ouyangcong3/LongShaoCPU/龙少设计CPU/KC-LS1u资料文件(更新1)/示例程序/TF_SD卡读写示例程序/程序说明.txt

读写内存卡(TF/SD).

内存卡连接定义:

/*------内存卡接 "KC_LS1u_SPI_C" 和 "KC_LS1u_SPI_D" PCB的J7接口

内存卡是接到J7接口. 
内存卡的 "VCC" 接 "3V" 
内存卡的 "GND" 接 "GND" 
内存卡的 "MISO" 接 "SI" 
内存卡的 "MOSI" 接 "SO" 
内存卡的 "SCK" 接 "SCK" 
内存卡的 "CS" 接 "S_CS0"

"S_CS0" ~ "S_CS7" ,分别为设备0到设备7
这里的8个SPI设备都共用SCK、SI、SO、VCC、GND这5条线,不同的是J7接口是3.3V,J8接口是5V

*/

程序功能: 把内存卡的0号扇区的数据复制到1号扇区.
