ouyangcong3/LongShaoCPU/龙少设计CPU/KC-LS1u资料文件(更新1)/示例程序/USB存储器(U盘)读写示例程序/程序说明.txt

读写USB存储器(U盘).

CH375连接定义:

/*----CH375 接 "KC_LS1u_CLK_RST_IO_PS" PCB上的J5、J6、J7、J8接口;

CH375的VCC和GND电源线接J7或J8接口上的VCC和GND;
CH375的D0~D7数据线接J7或J8接口上的D0~D7;
CH375的WR和RD读写线接J7或J8接口上的WR和RD;
CH375的A0线接J7或J8接口上的A0;
CH375的CS片选线J5或J6接口上的CS0;
CH375的INT中断信号线接J5或J6接口上的IT0;

CS0~CS7,为设备0~设备8;
IT0~IT7,为设备0~设备8;

这里程序支持4片CH375, 也就是CS0~CS3和IT0~IT3可以接4片CH375, 4片CH375的D0~D7、WR、RD、A0、VCC、GND共用, 如果不够可以扩展出来;

*/

程序功能: 每次插入USB存储器,就会把存储器0号扇区的数据复制到1号扇区.
