ouyangcong3/LongShaoCPU/龙少设计CPU/KC-LS1u资料文件(更新1)/示例程序/扬声器示例程序/程序说明.txt

测试扬声器.

扬声器连接定义:

/* 扬声器接 "KC_LS1u_CLK_RST_IO_PS" PCB 的"Speaker"接口*/
