ouyangcong3/LongShaoCPU/龙少设计CPU/龙少各帖子说明.pdf龙少各帖子说明.pdf

1.用Multisim 11.0画了个CPU来玩玩(纯硬件、开源、原创) 制作了最早 的龙少八位机，发布了多页的纸质说明
2.龙少精简炮灰测试版8位机(原创、纯硬件、开源) 使用洞洞版制作外 设卡，使用整块自制pcb制作了主体，发布了架构图，PCB制作过程，CPU 的使用说明，CPU的寄存器，CPU的寻址方式、指令、和机器码，自己的经 历，简单地讲解了一下运作过程，发布了汇编器，发布硬件SPI，有人给 他制作了C语言的编译器
3.正在测试小UU外设部分(不定时更新) 计划运行程序HTTP服务器，制作 了ROM下载器，测试了VGA-RGB的D--A部分，投入到显示卡的研发中，制作 了SPI收发板，介绍了造CPU, 写编译器, 网络协议, VGA显示的基础原理 的图书，发布了二元式CPU指令生成程序，更新了SPI收发电路，显卡分辨 率调整电路从240 X 240 改为256(宽) X 240(高) 4.YY了一个单周期自动机(独家原创含讲解) 发布了基本结构，执行代码 时各寄存器的导路，产生了二级流水线
5.龙少精简嗨爆版8位单周期CPU内核原创电路发布(计划出套件) 发布完 整指令集，完成如今的14片10×10cm主板
6.DIY的测试版8位计算机完整原创电路和部分程序发布 发布较为完整的 资料
7.KC-LS1u简介和预订 有关于转换视频的教程，发现设计有误、添加c寄 存器
8.74门电路8位计算机KC-LS1u部分资料发布 打包新文件，发布反汇编器 9.74门电路8位计算机KC-LS1u资料(更新1) 最后一次发布文件

龙少最后一次登录科创：2017-08-17 16:23

Emmm,对龙少的8位74门机子比较感兴趣，但由于他的帖子比较杂乱，为了方 便各位的阅读，在此小小地整合了一下他的所有帖子的内容索引，后面的越写越少 真的不是我的错23333，哦，对了那啥——严禁用作商业用途（真有的话我只能佩 服一句吃饱了撑的233）
——左手执者 2018-9-13
阿诺内，阿诺内（自行脑补血小板音效）我最近也在做74门计算机，有兴趣的欢迎
关顾一下寒舍吧 科创： Click Here (https://www.kechuang.org/m/76042) | B站： Click Here (https://space.bilibili.com/28690875/#/)
