ouyangcong3/LongShaoCPU/龙少设计CPU/KC-LS1u资料文件(更新1)/示例程序/USB键盘示例程序/DSCF5973.JPG

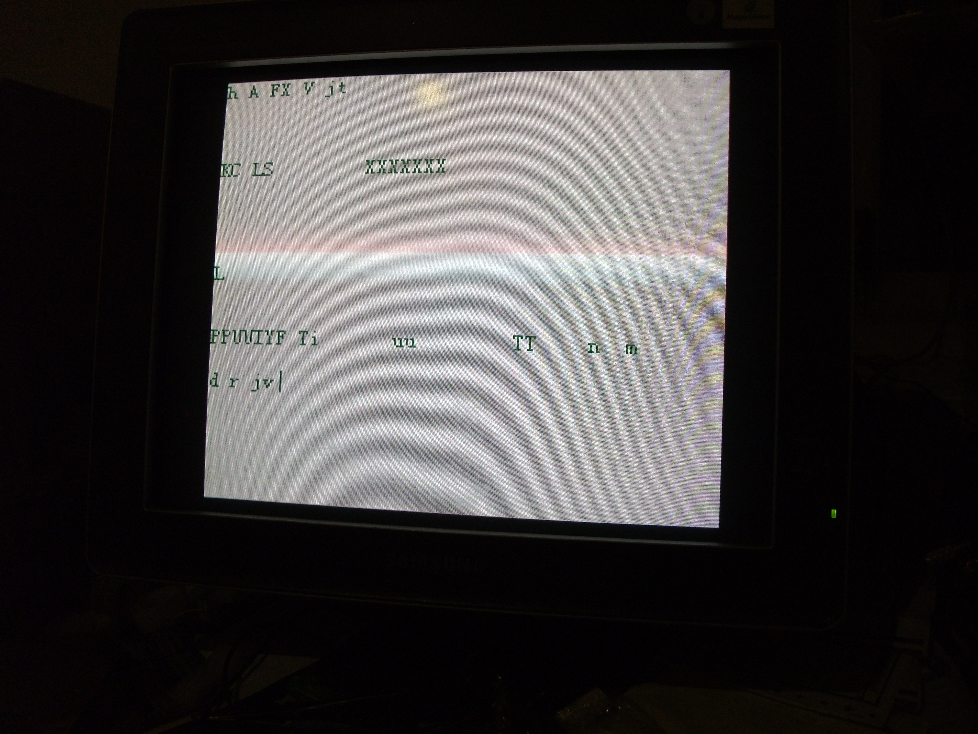
龙少设计CPU/KC-LS1u资料文件(更新1)/示例程序/USB键盘示例程序/DSCF5973.JPG
