ouyangcong3/LongShaoCPU/龙少设计CPU/KC-LS1u资料文件(更新1)/示例程序/USB鼠标示例程序/DSCF5983.JPG

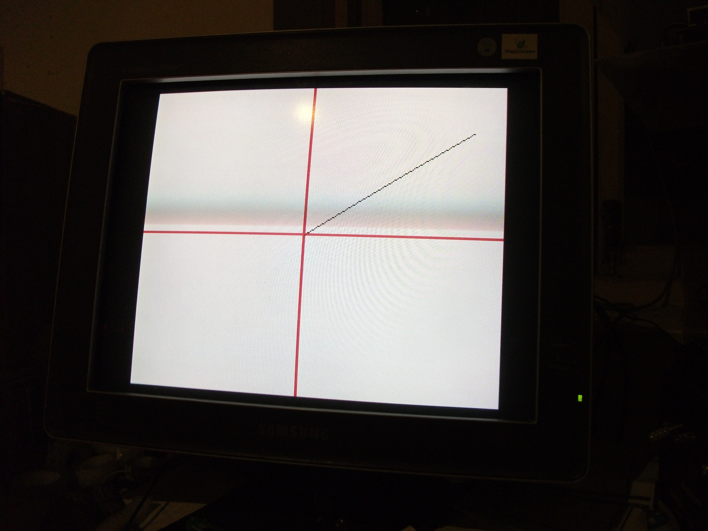
龙少设计CPU/KC-LS1u资料文件(更新1)/示例程序/USB鼠标示例程序/DSCF5983.JPG
