ouyangcong3/LongShaoCPU/龙少设计CPU/KC-LS1u资料文件(更新1)/示例程序/VGA显存读写示例程序/代码.png

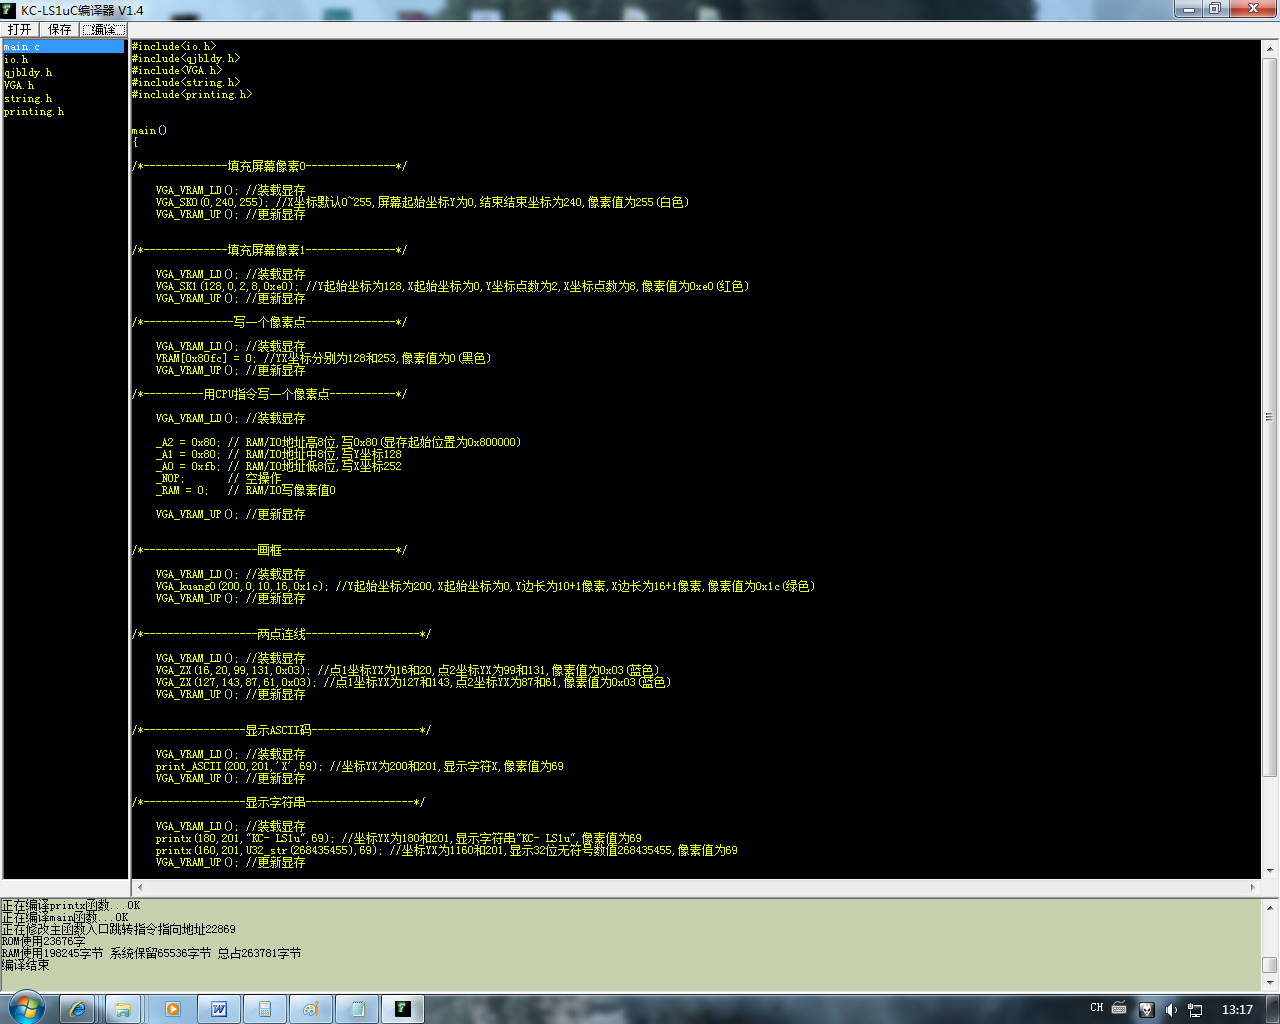
龙少设计CPU/KC-LS1u资料文件(更新1)/示例程序/VGA显存读写示例程序/代码.png
