ouyangcong3/LongShaoCPU/龙少设计CPU/KC-LS1u资料文件(更新1)/示例程序/显示中文字符串示例程序/程序运行效果.JPG

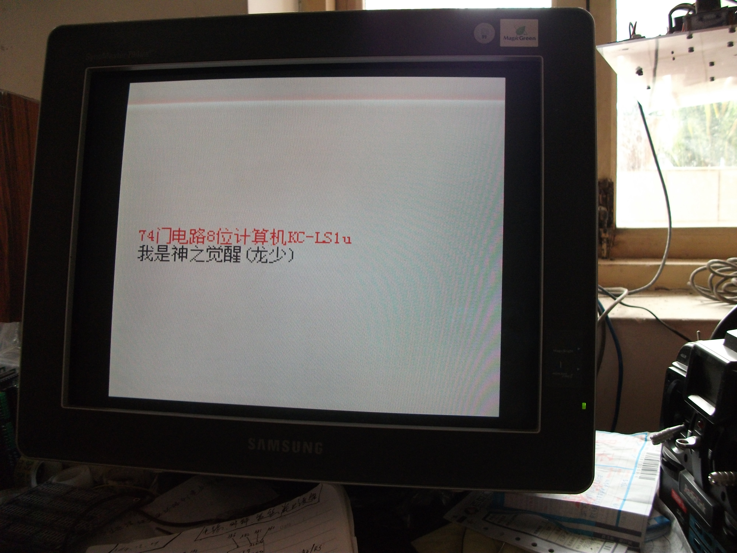
龙少设计CPU/KC-LS1u资料文件(更新1)/示例程序/显示中文字符串示例程序/程序运行效果.JPG
