ouyangcong3/LongShaoCPU/龙少设计CPU/KC-LS1u资料文件(更新1)/示例程序/目前硬件配置/DSCF6041.JPG

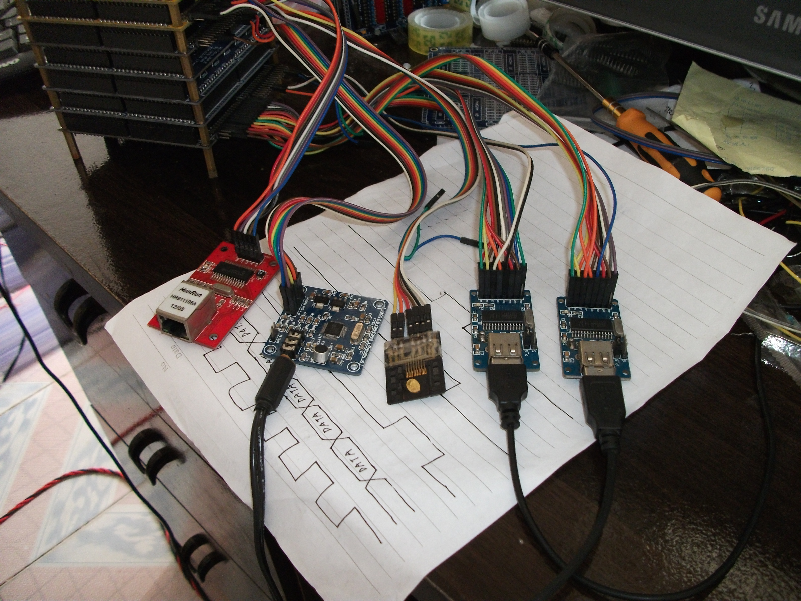
龙少设计CPU/KC-LS1u资料文件(更新1)/示例程序/目前硬件配置/DSCF6041.JPG
