ouyangcong3/LongShaoCPU/龙少设计CPU/KC-LS1u资料文件(更新1)/示例程序/程序使用说明.png

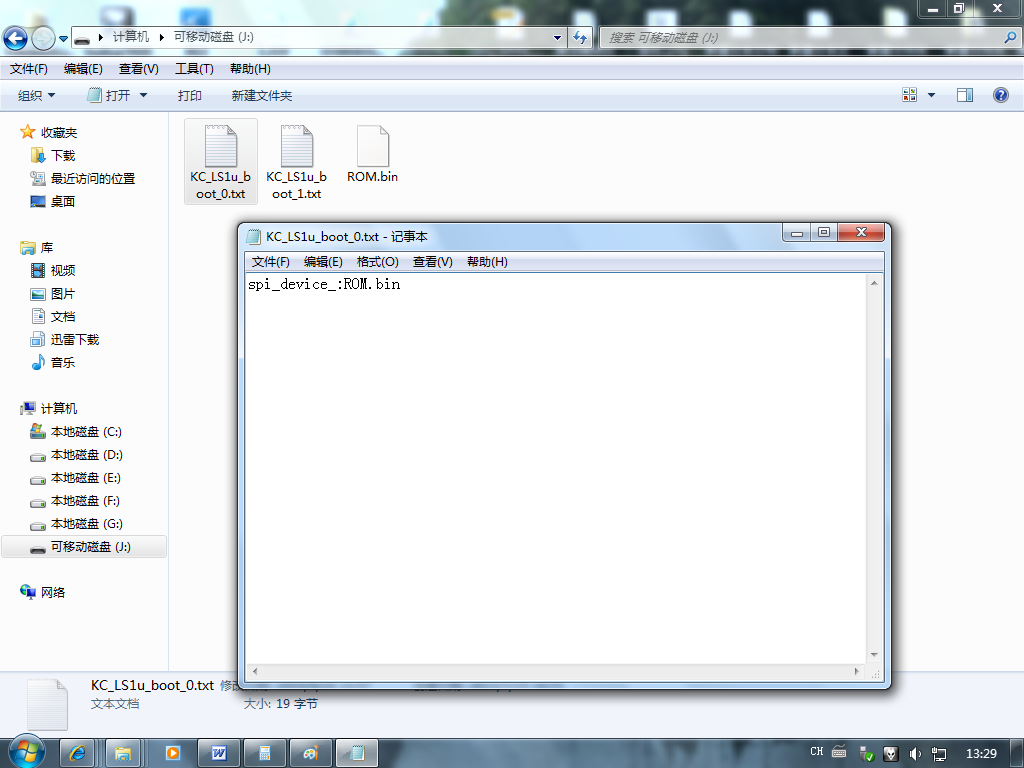
龙少设计CPU/KC-LS1u资料文件(更新1)/示例程序/程序使用说明.png
