ouyangcong3/LongShaoCPU/龙少设计CPU/龙少电路图整理.pdf

# LED

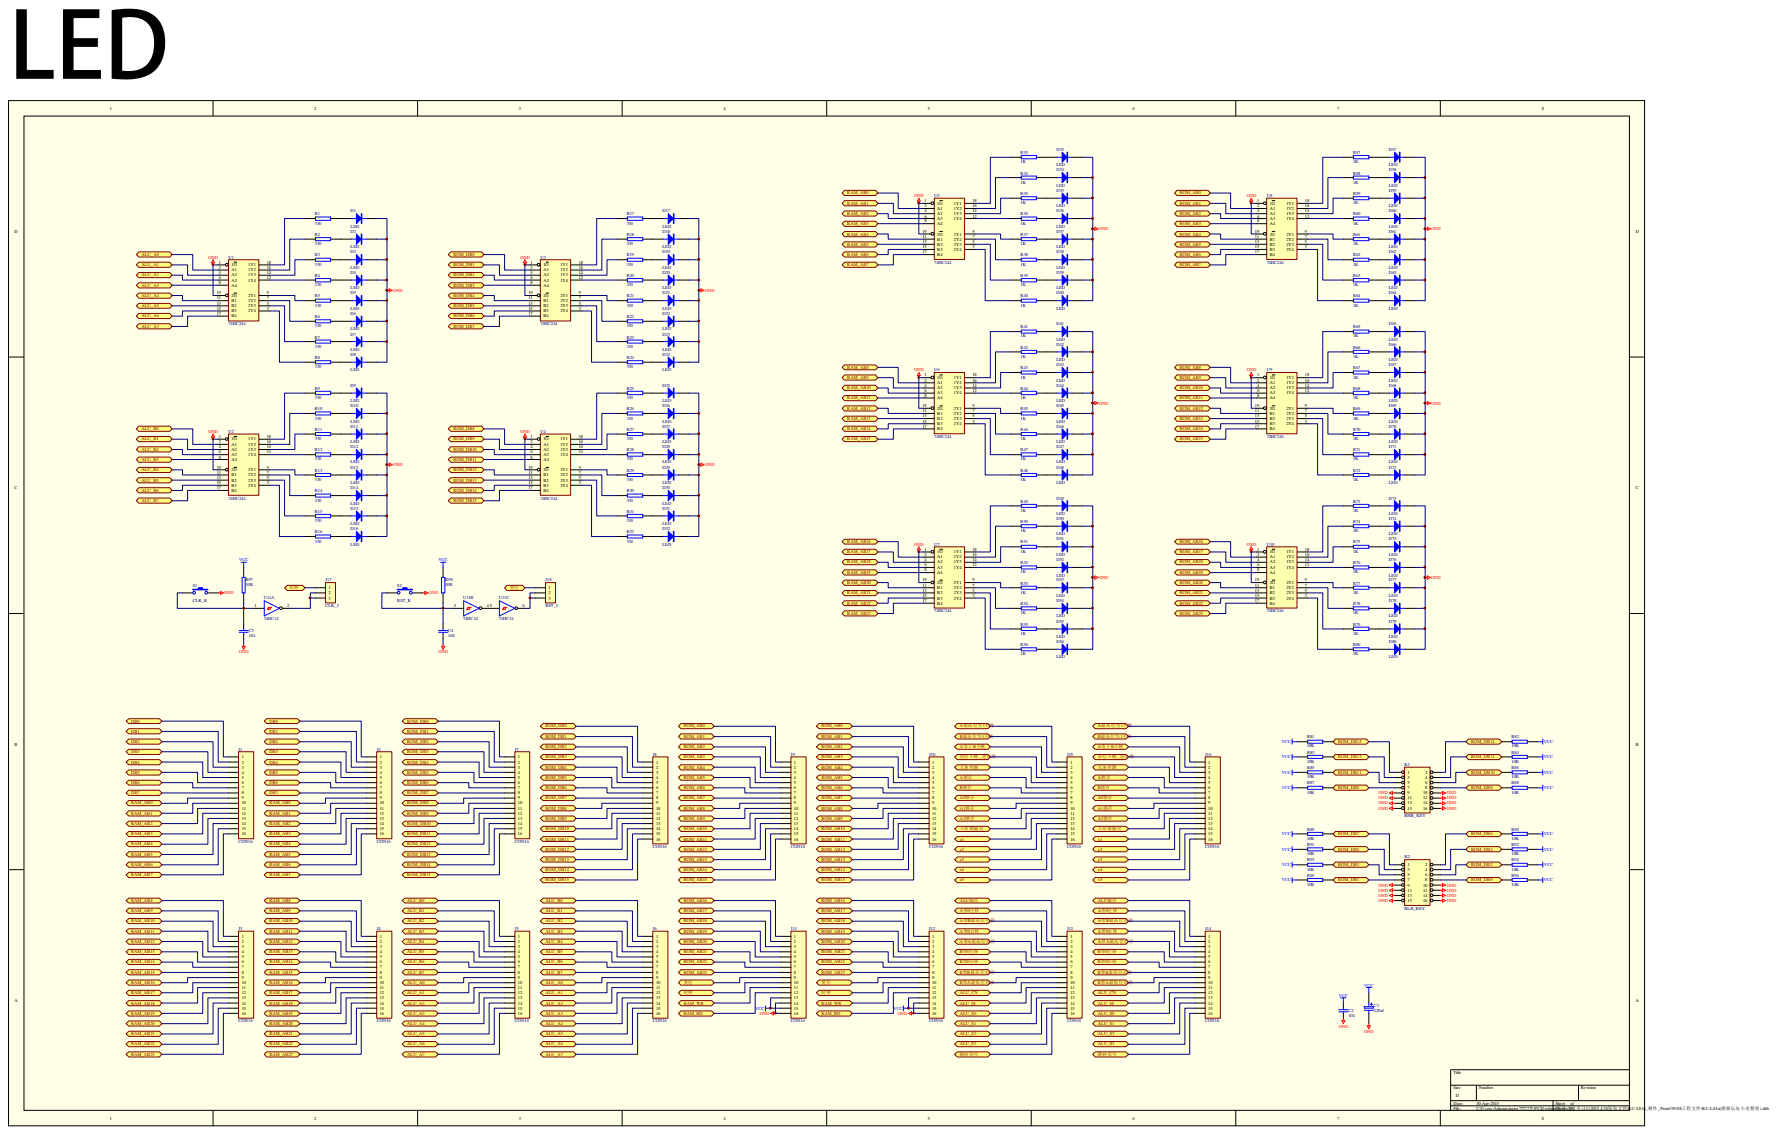
[picture p21: page 1]

VCC VCC

GND GND

# ALU

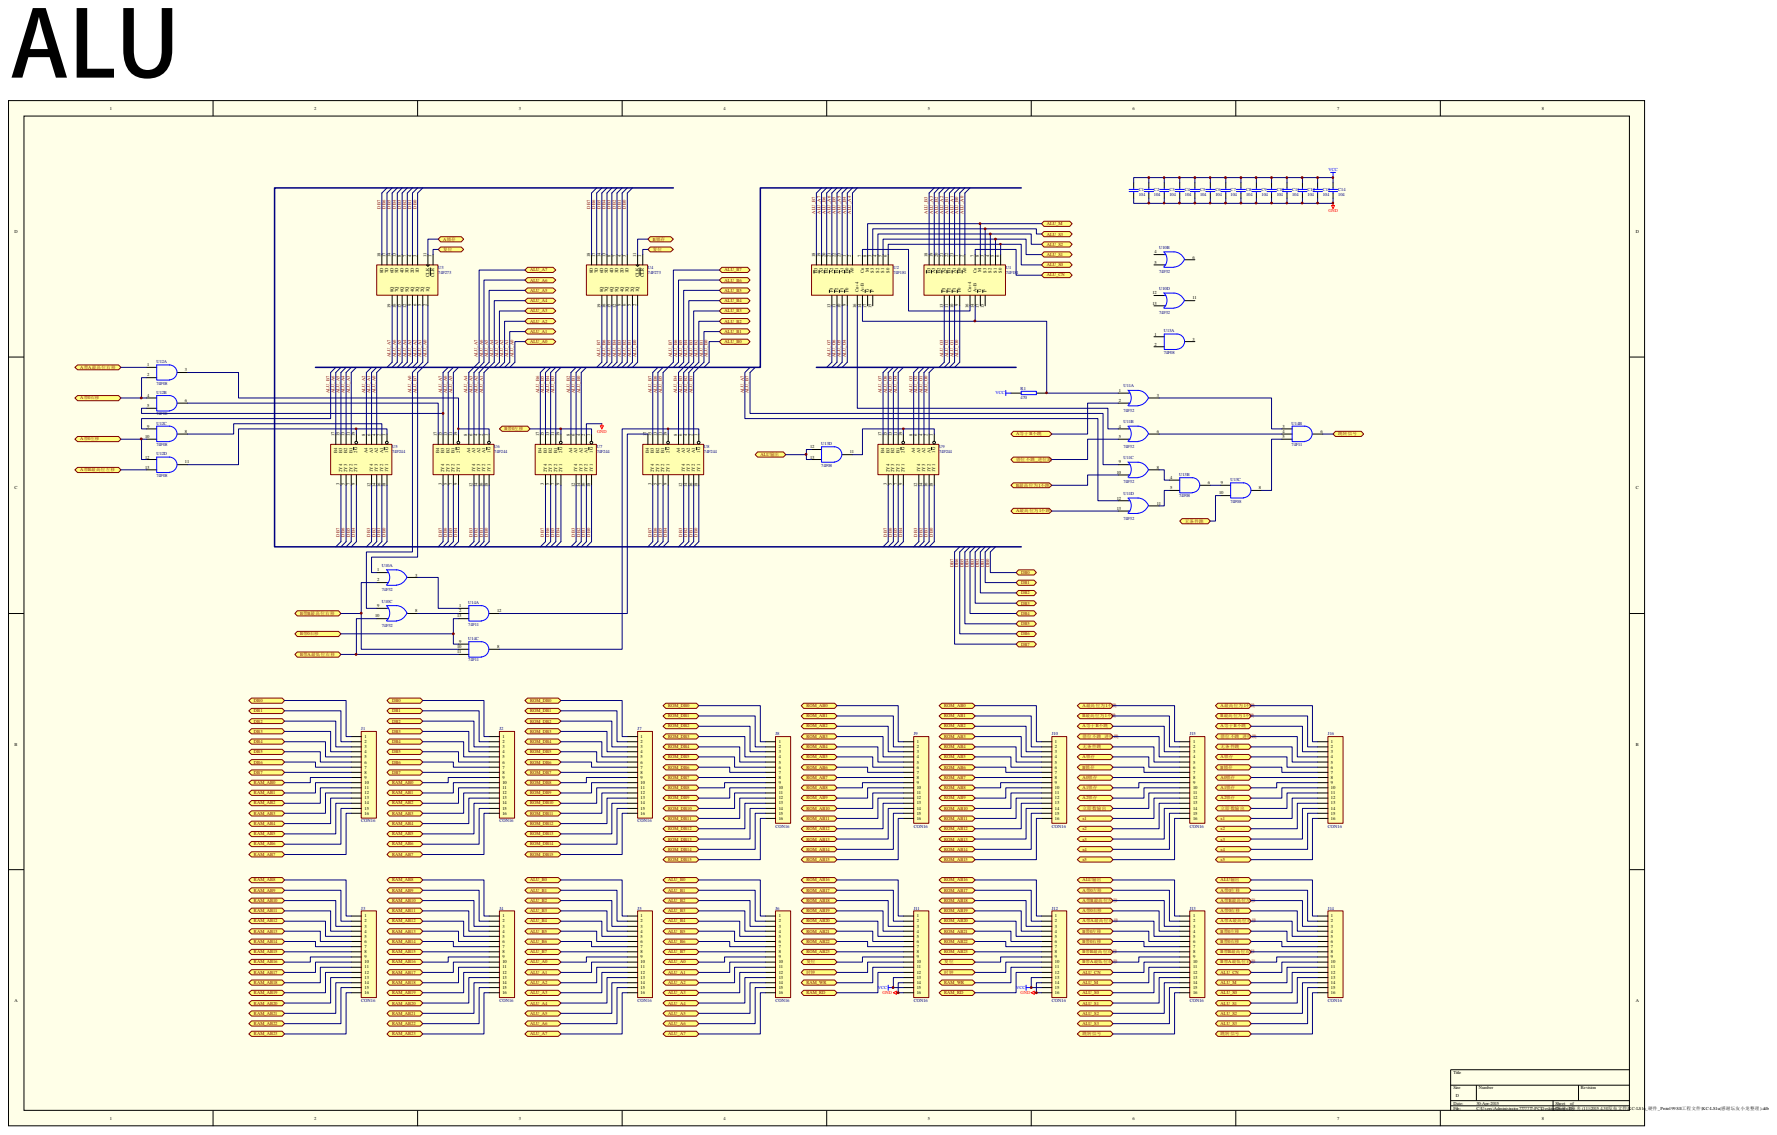
[picture p22: page 2]

A&D

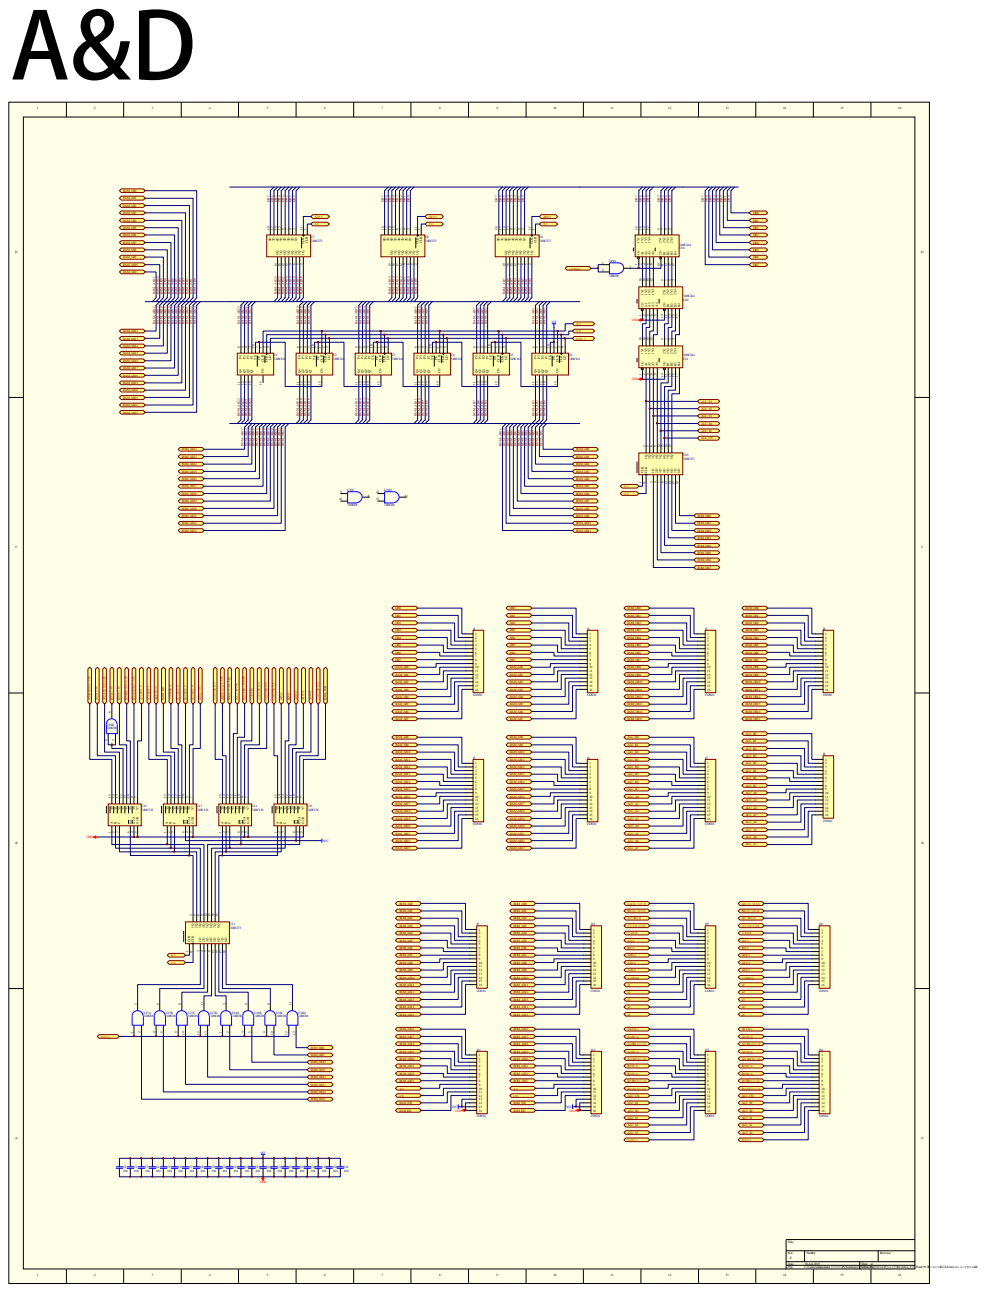
[picture p23: page 3]

# EEPROM

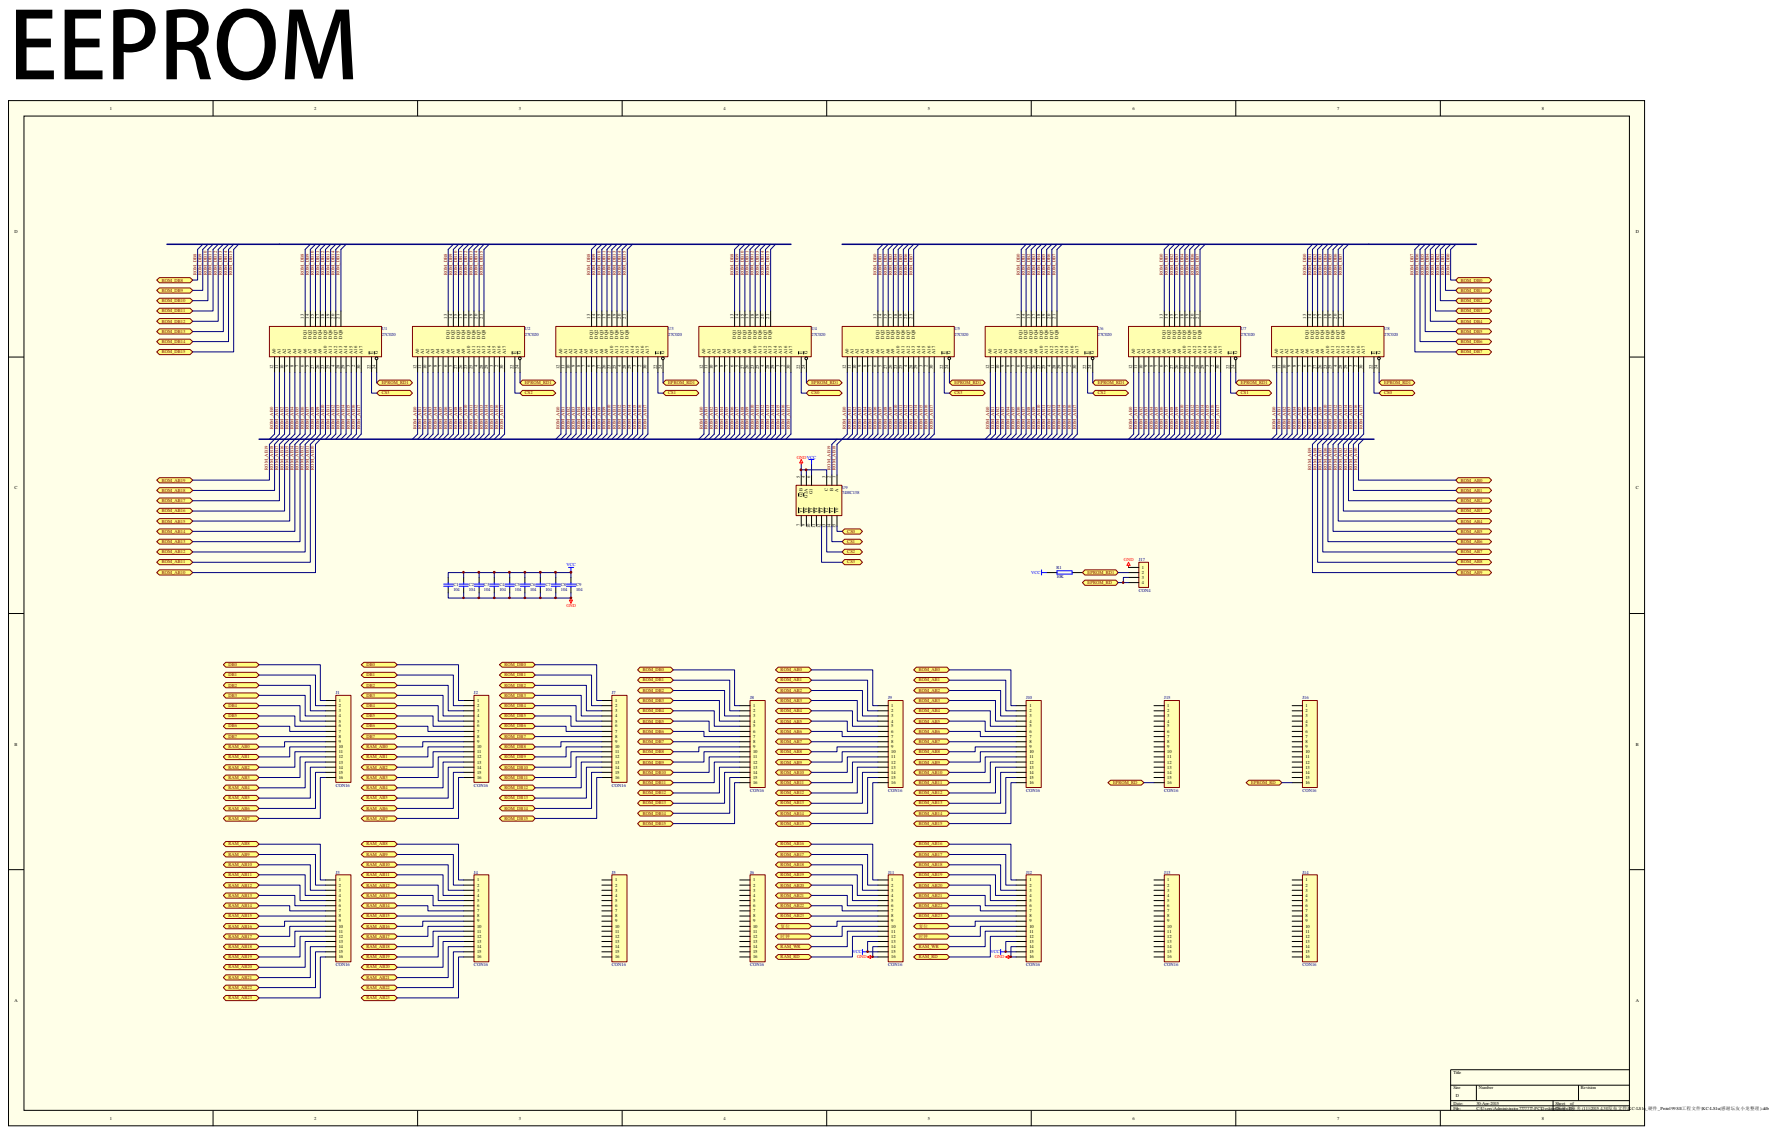
[picture p24: page 4]

# ROM_CT

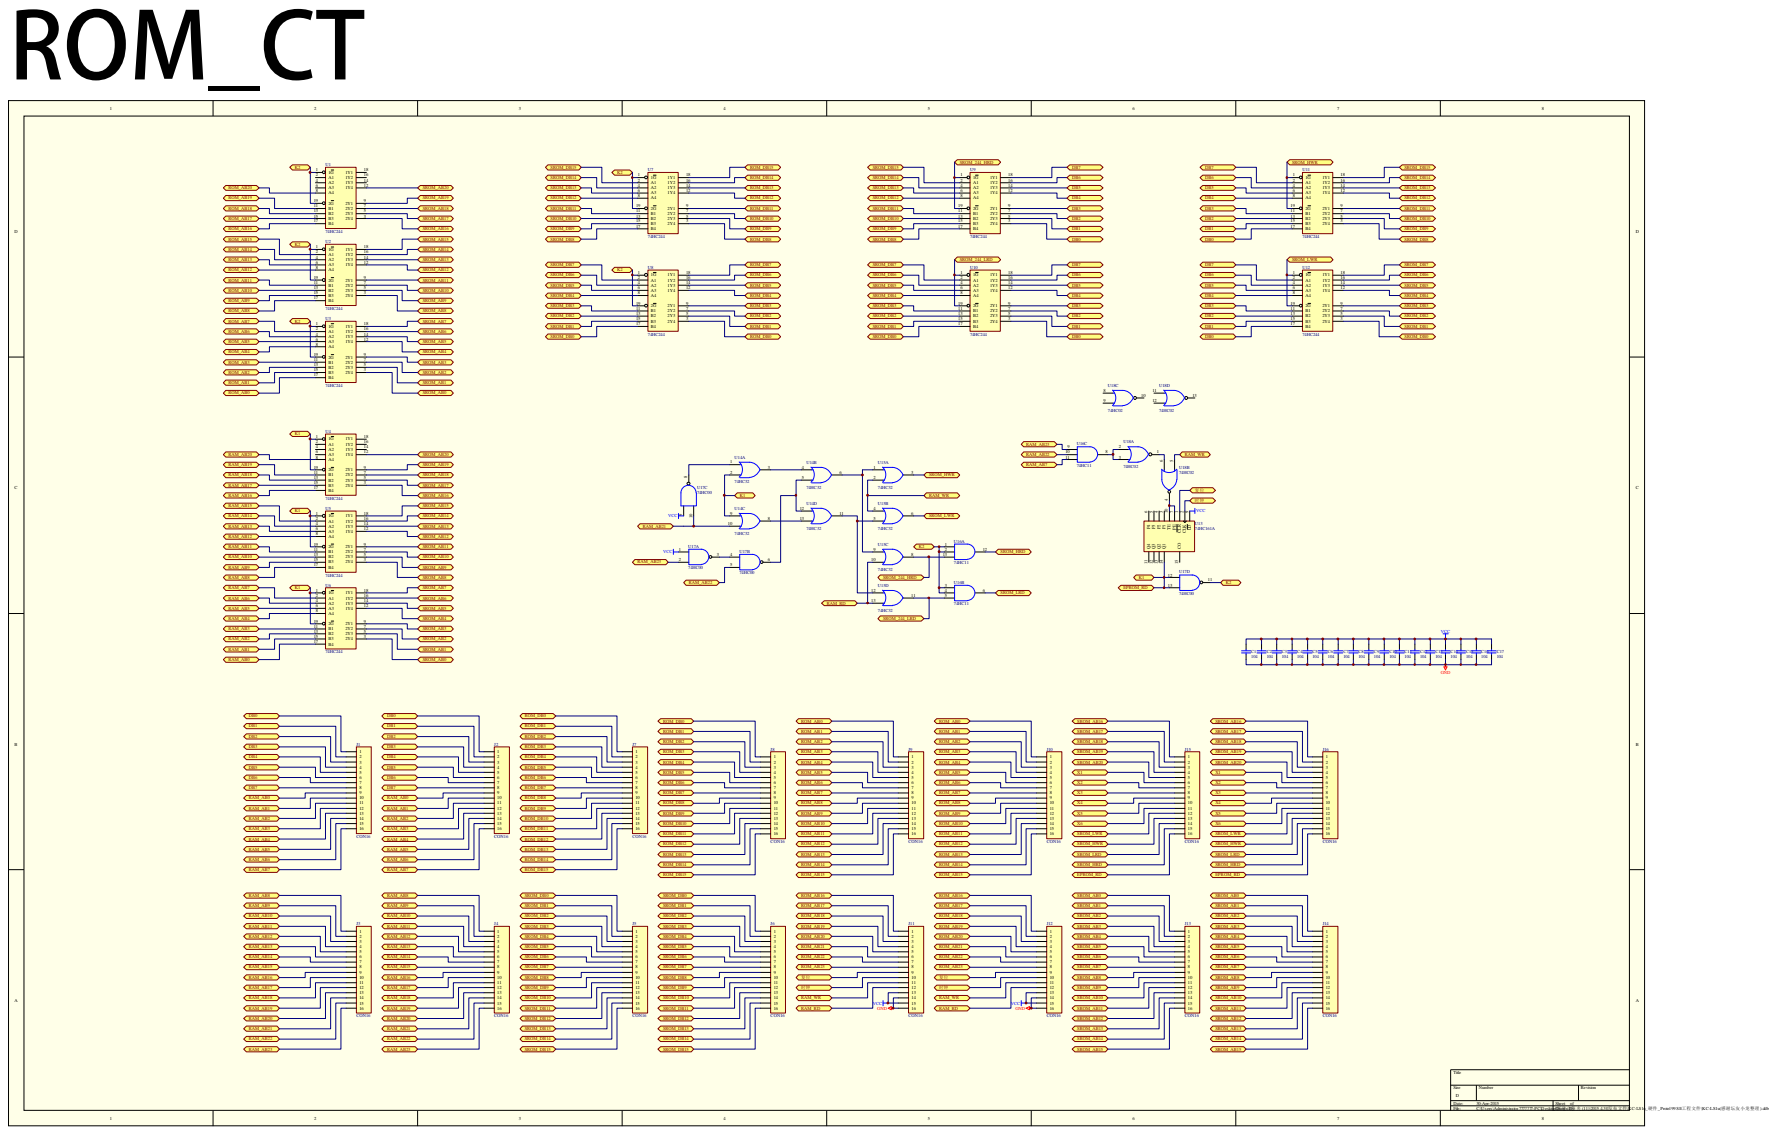
[picture p25: page 5]

# SROM

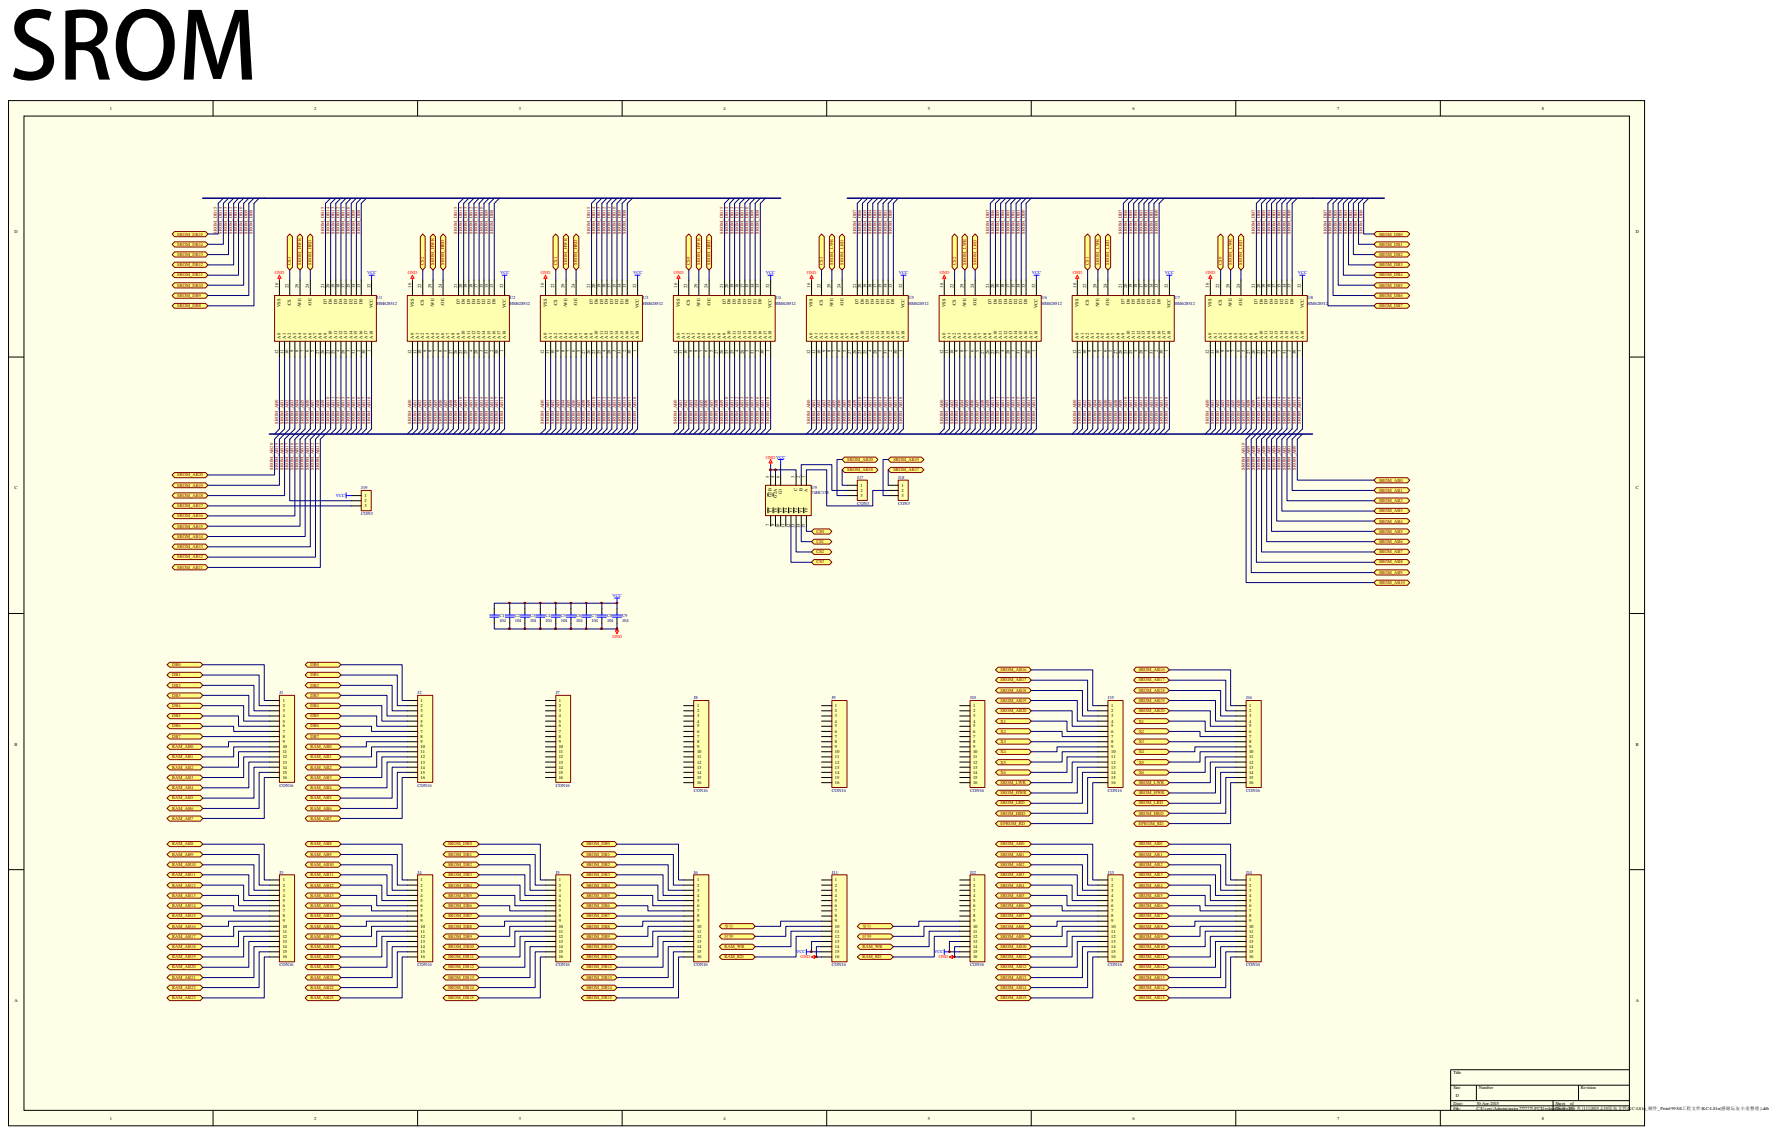
[picture p26: page 6]

# RAM

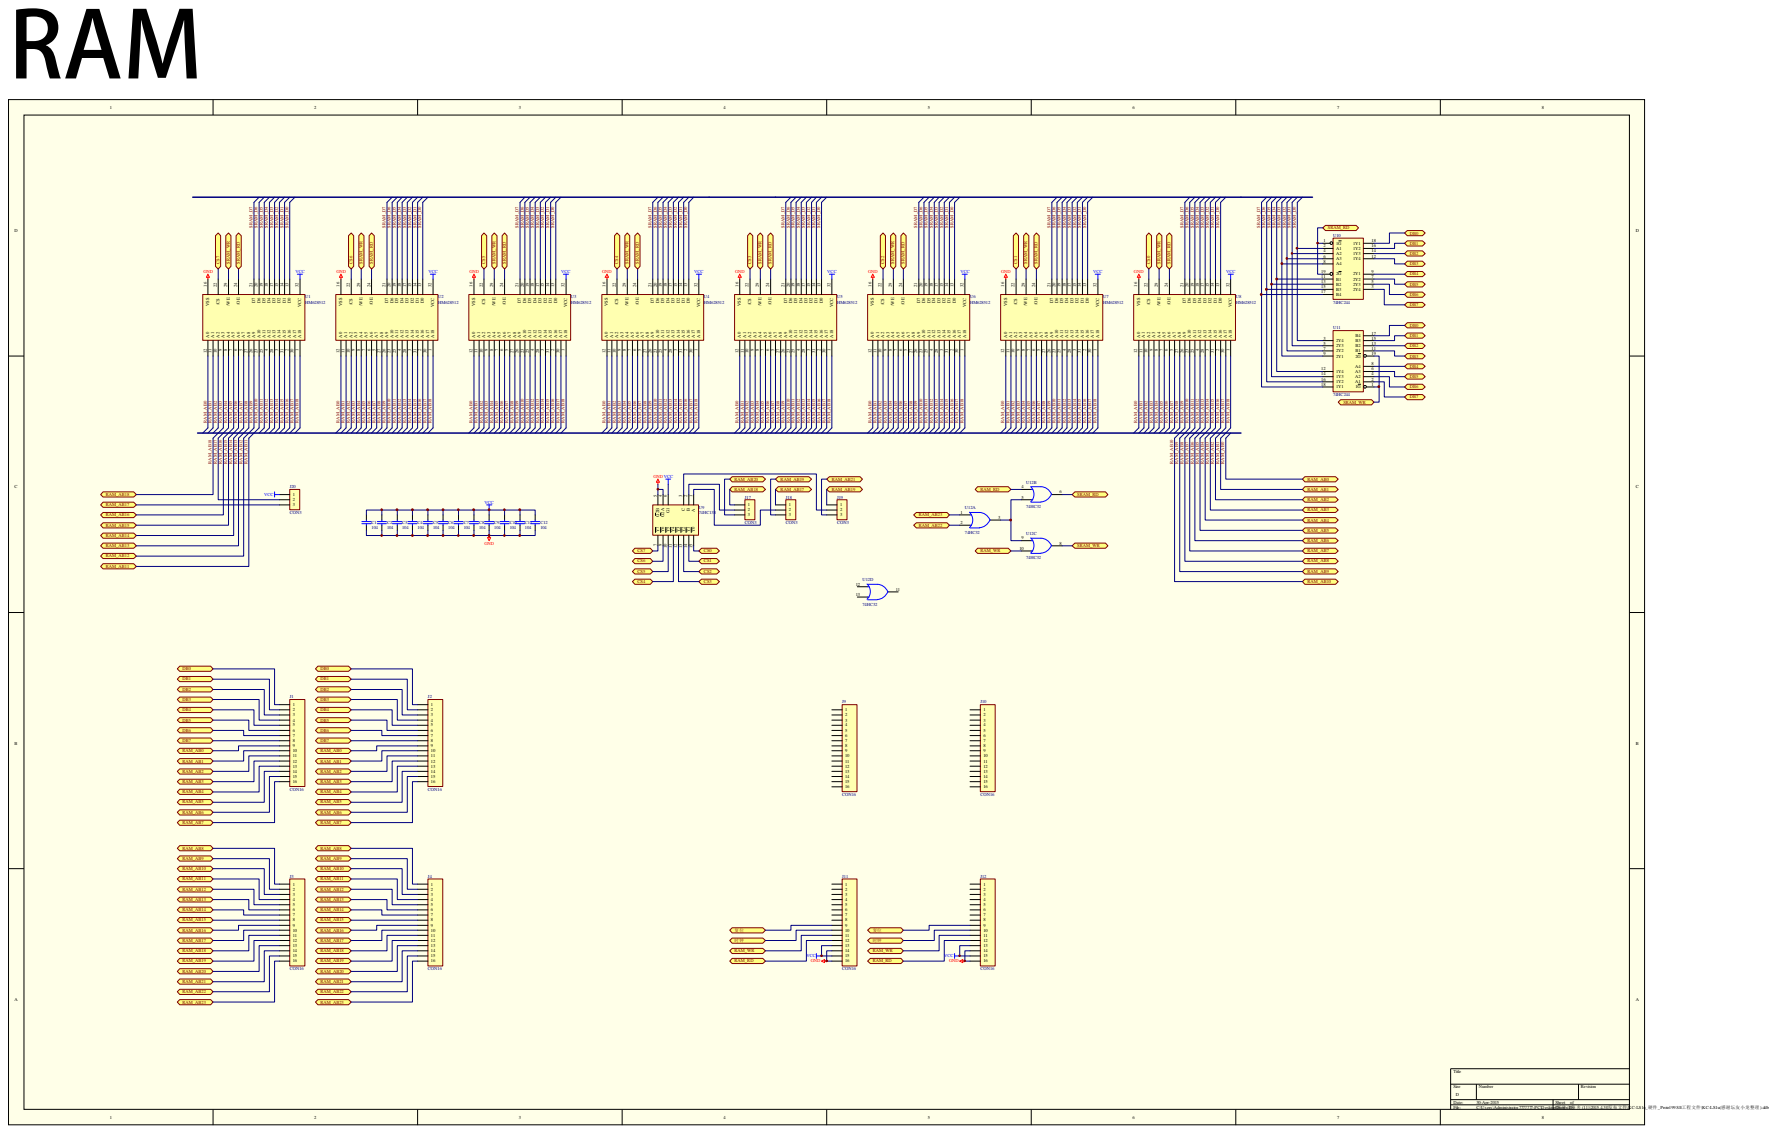
[picture p27: page 7]

# SPI_C

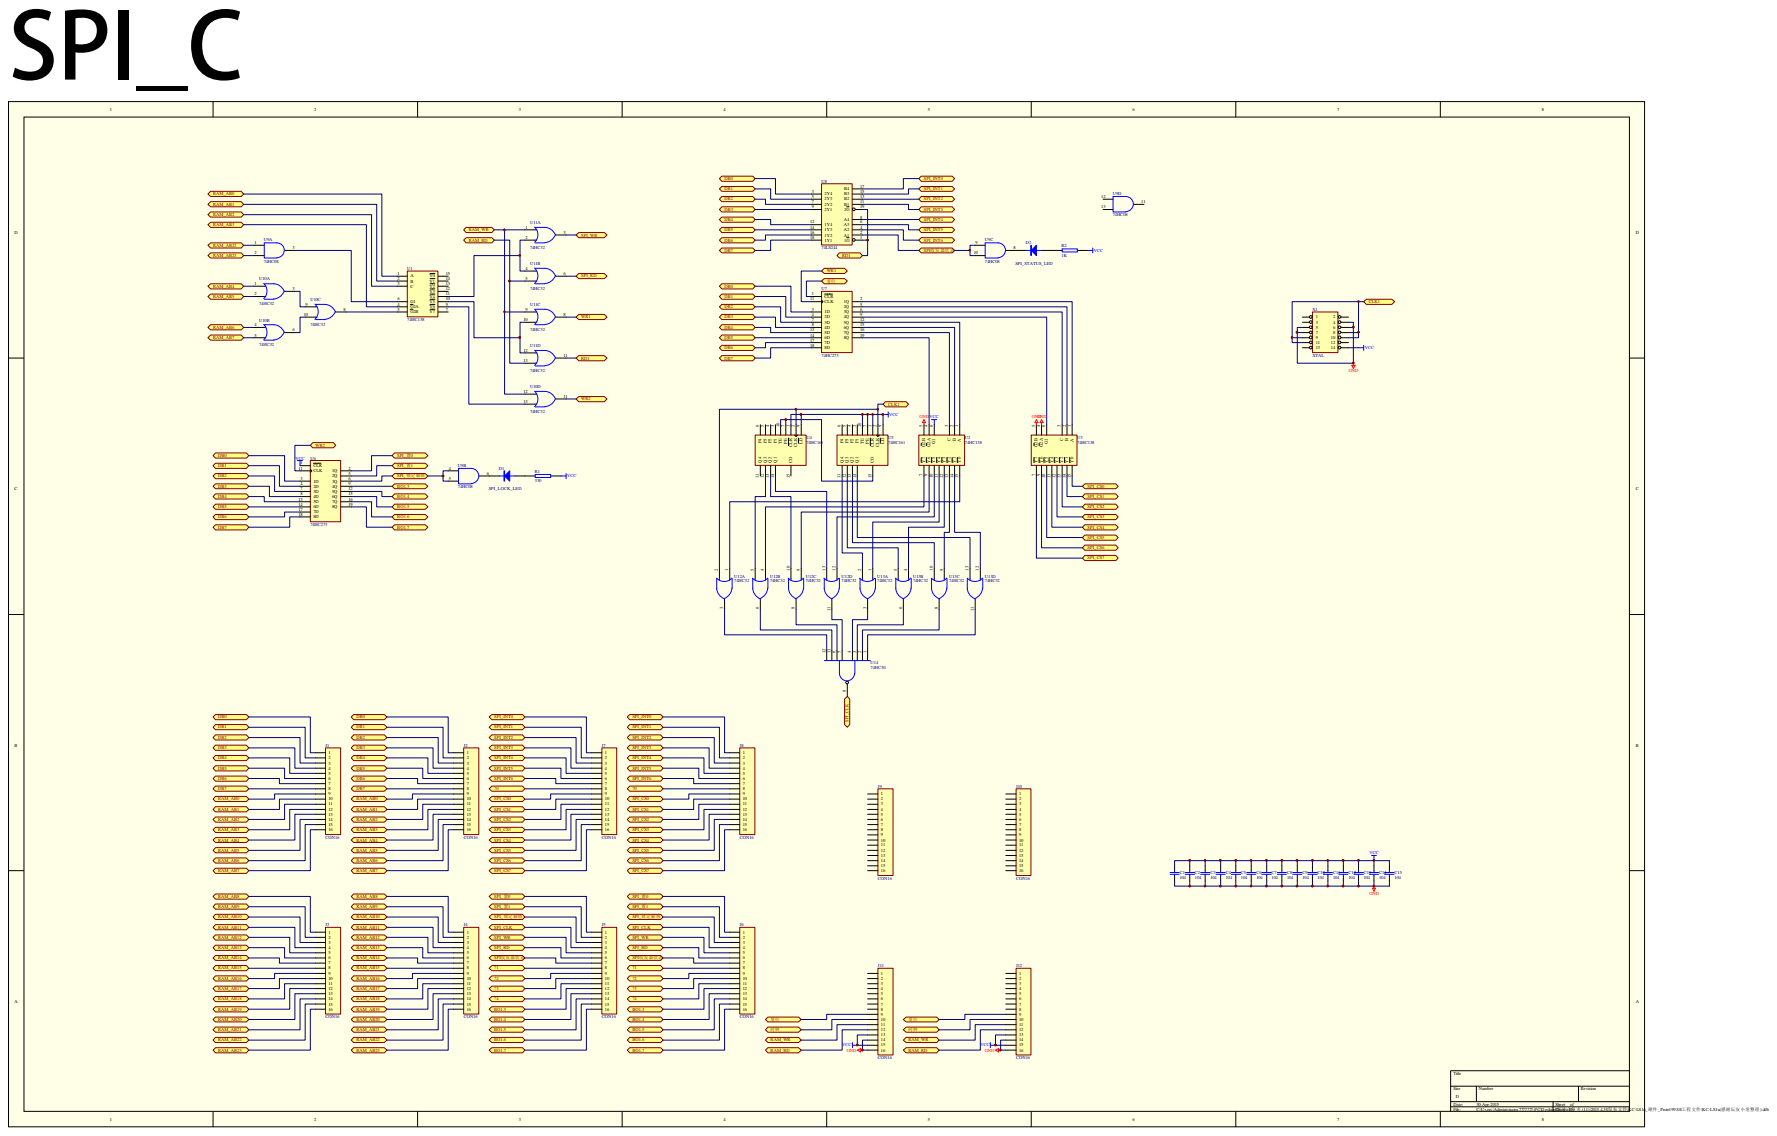
[picture p28: page 8]

# SPI_D

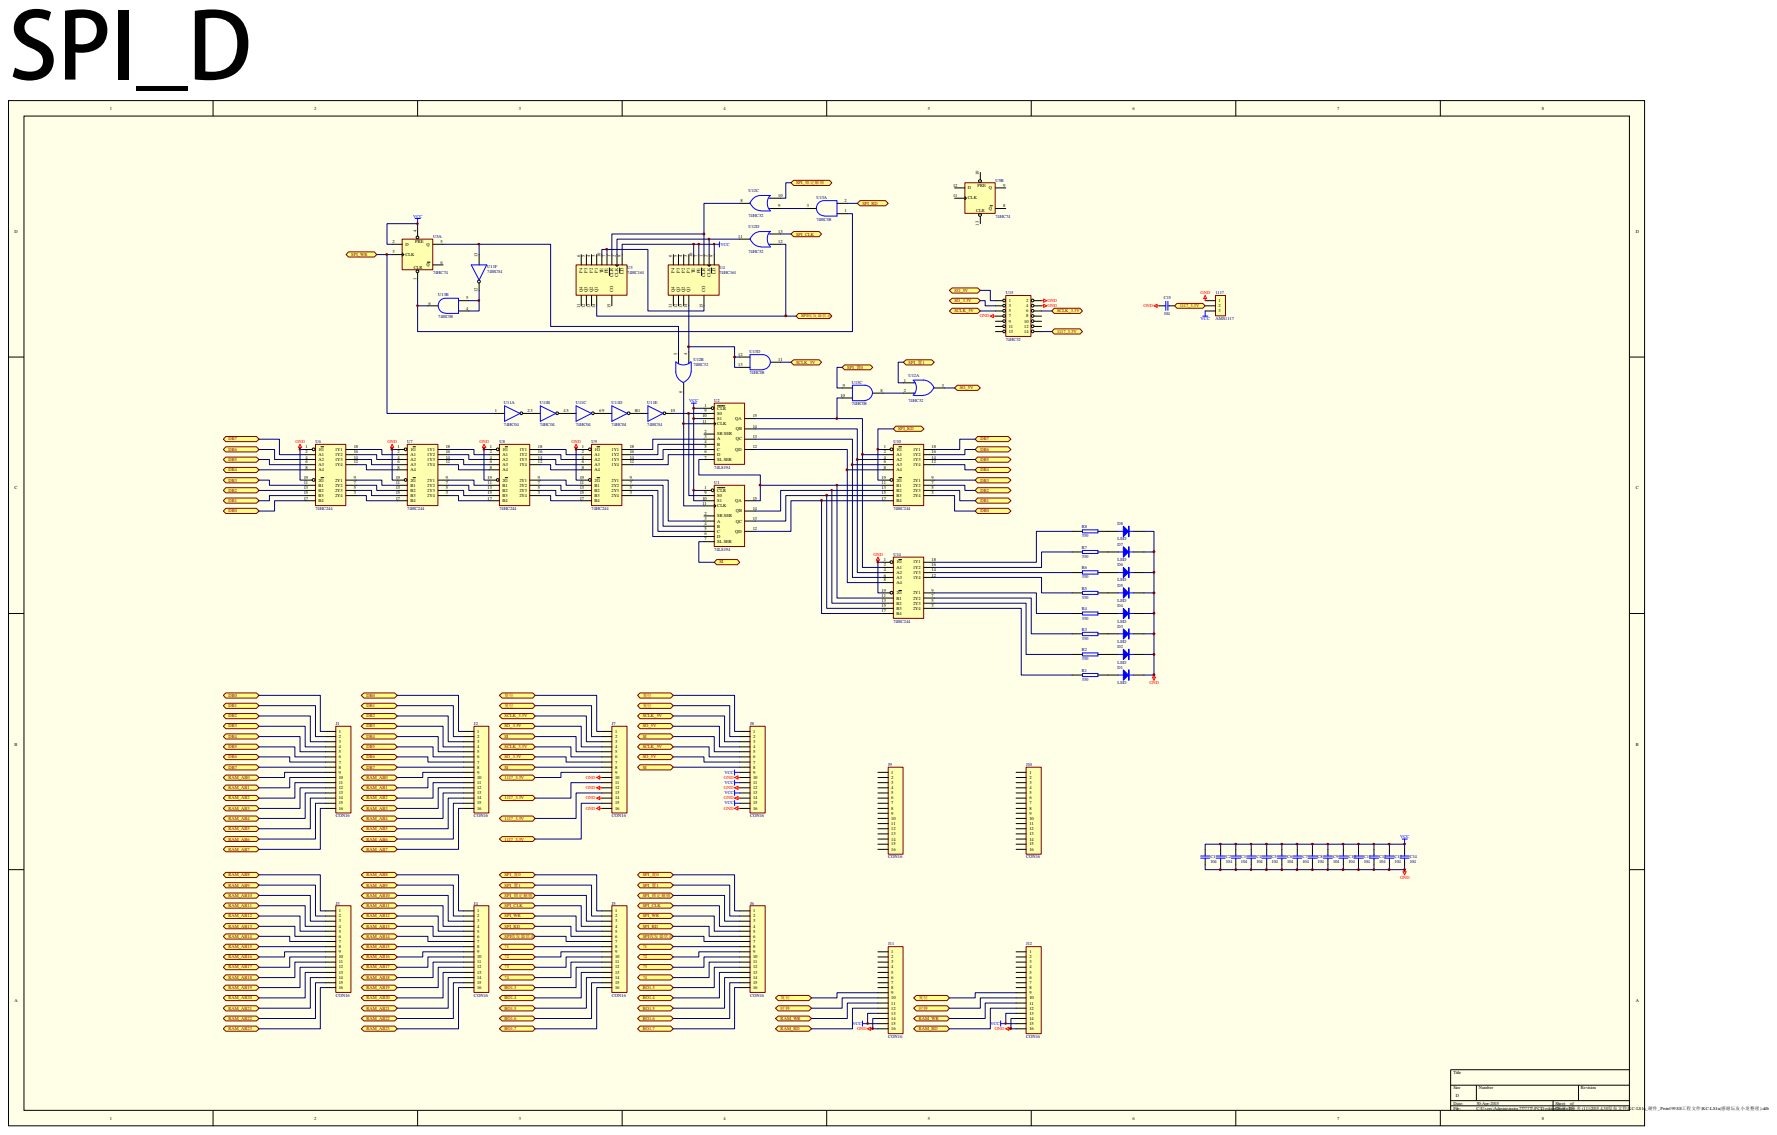
[picture p29: page 9]

# CT&VGA_CS

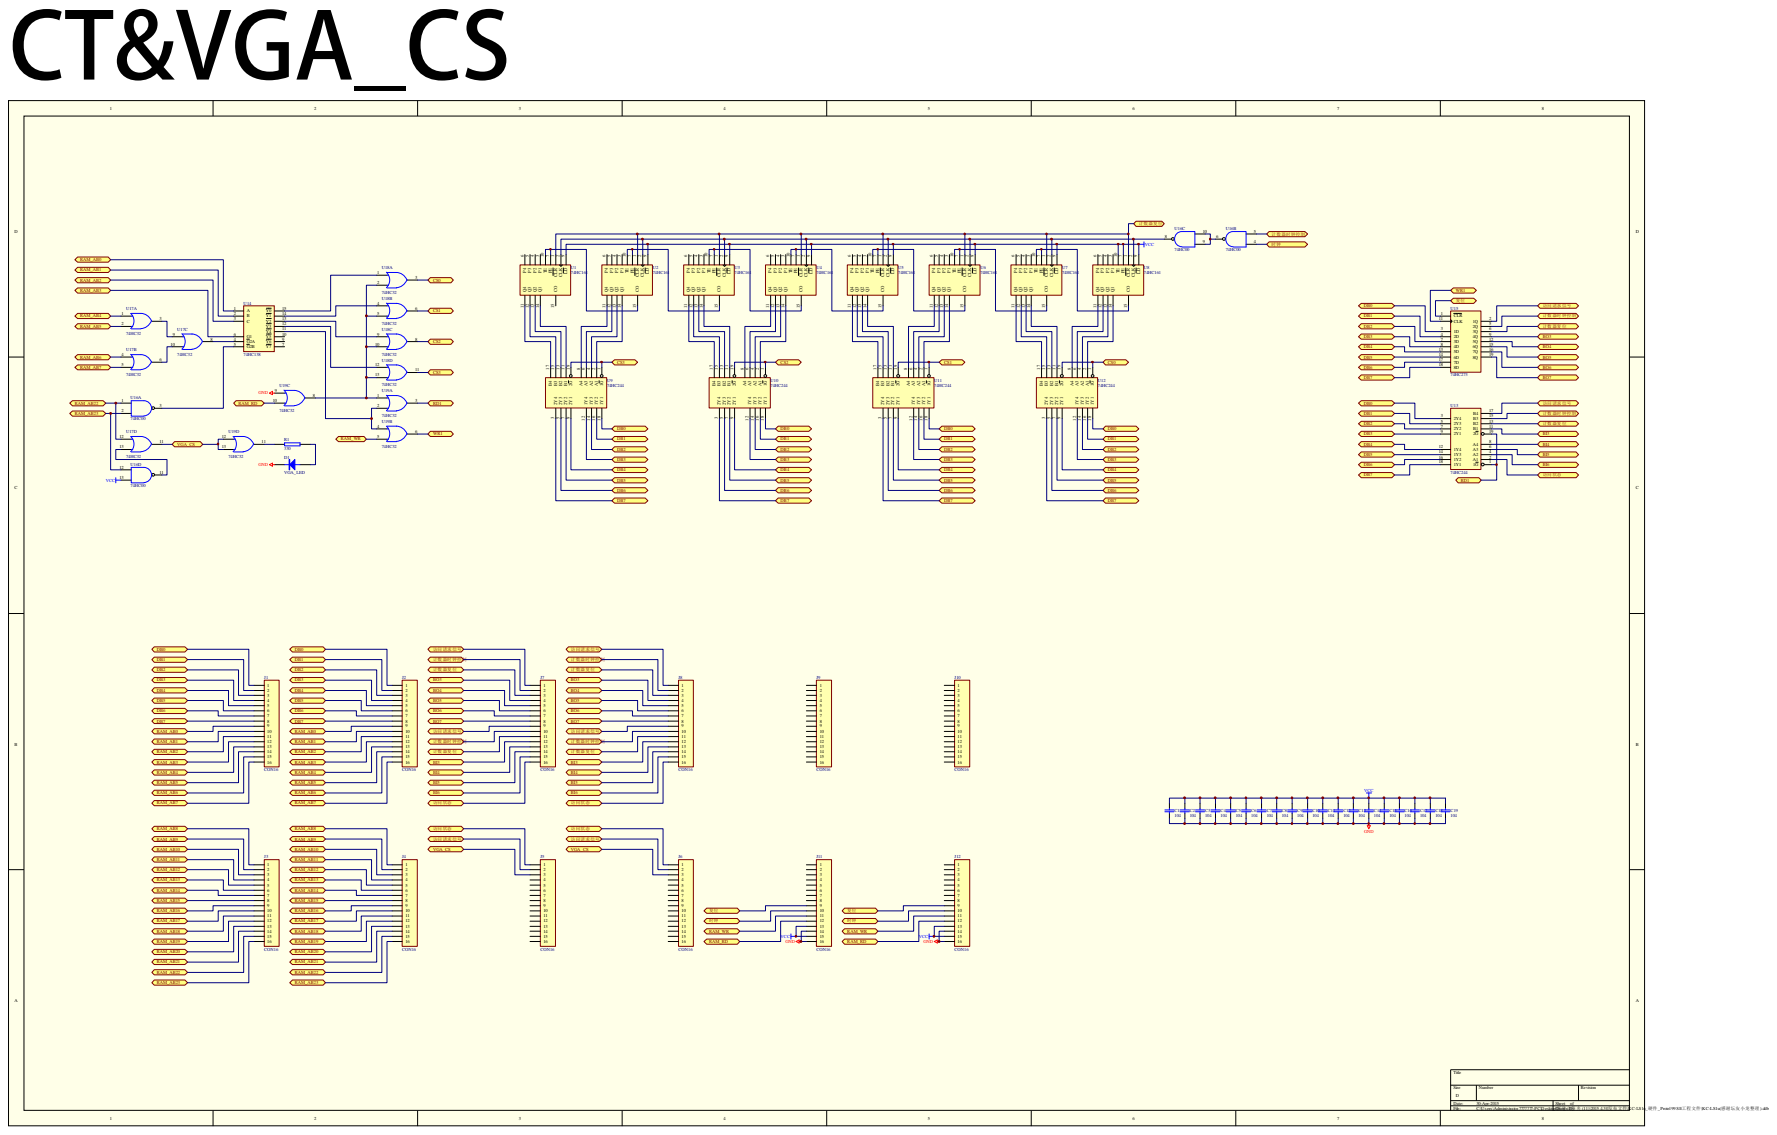
[picture p30: page 10]

# VGA_C

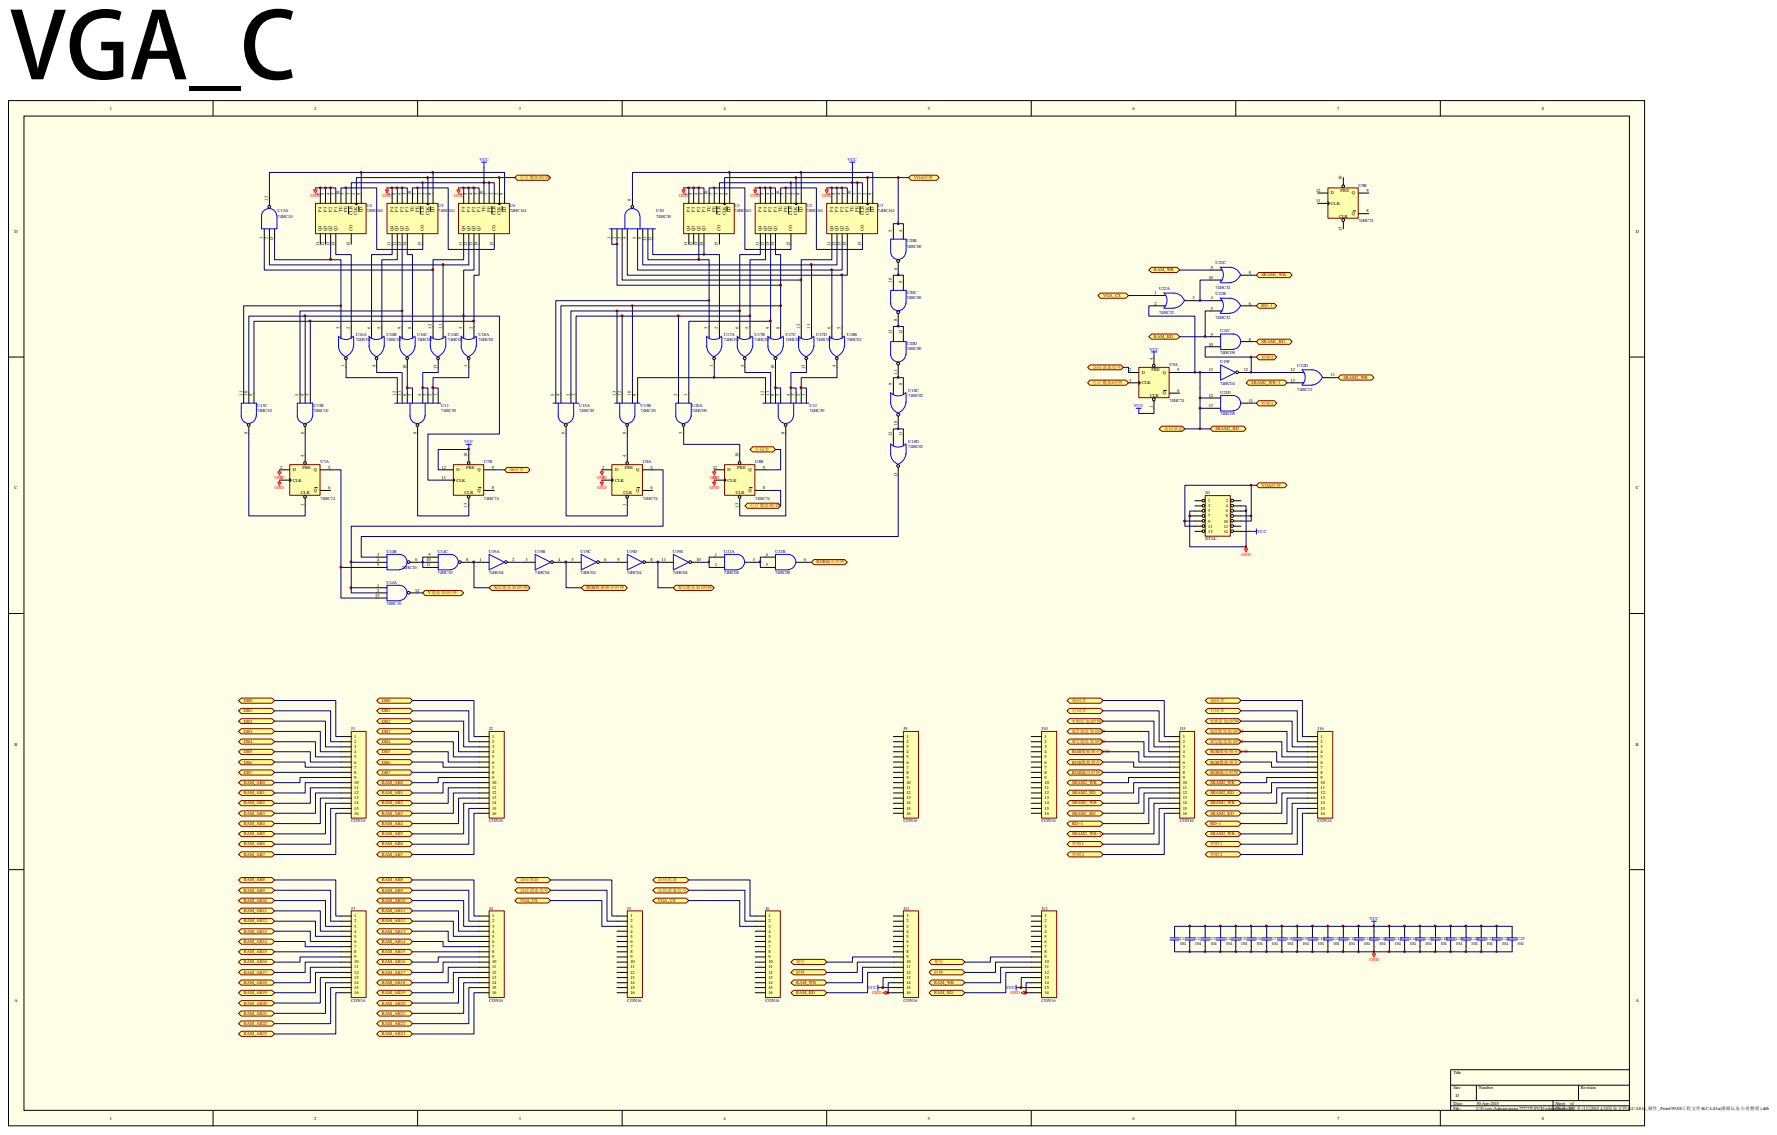
[picture p31: page 11]

# VGA_A

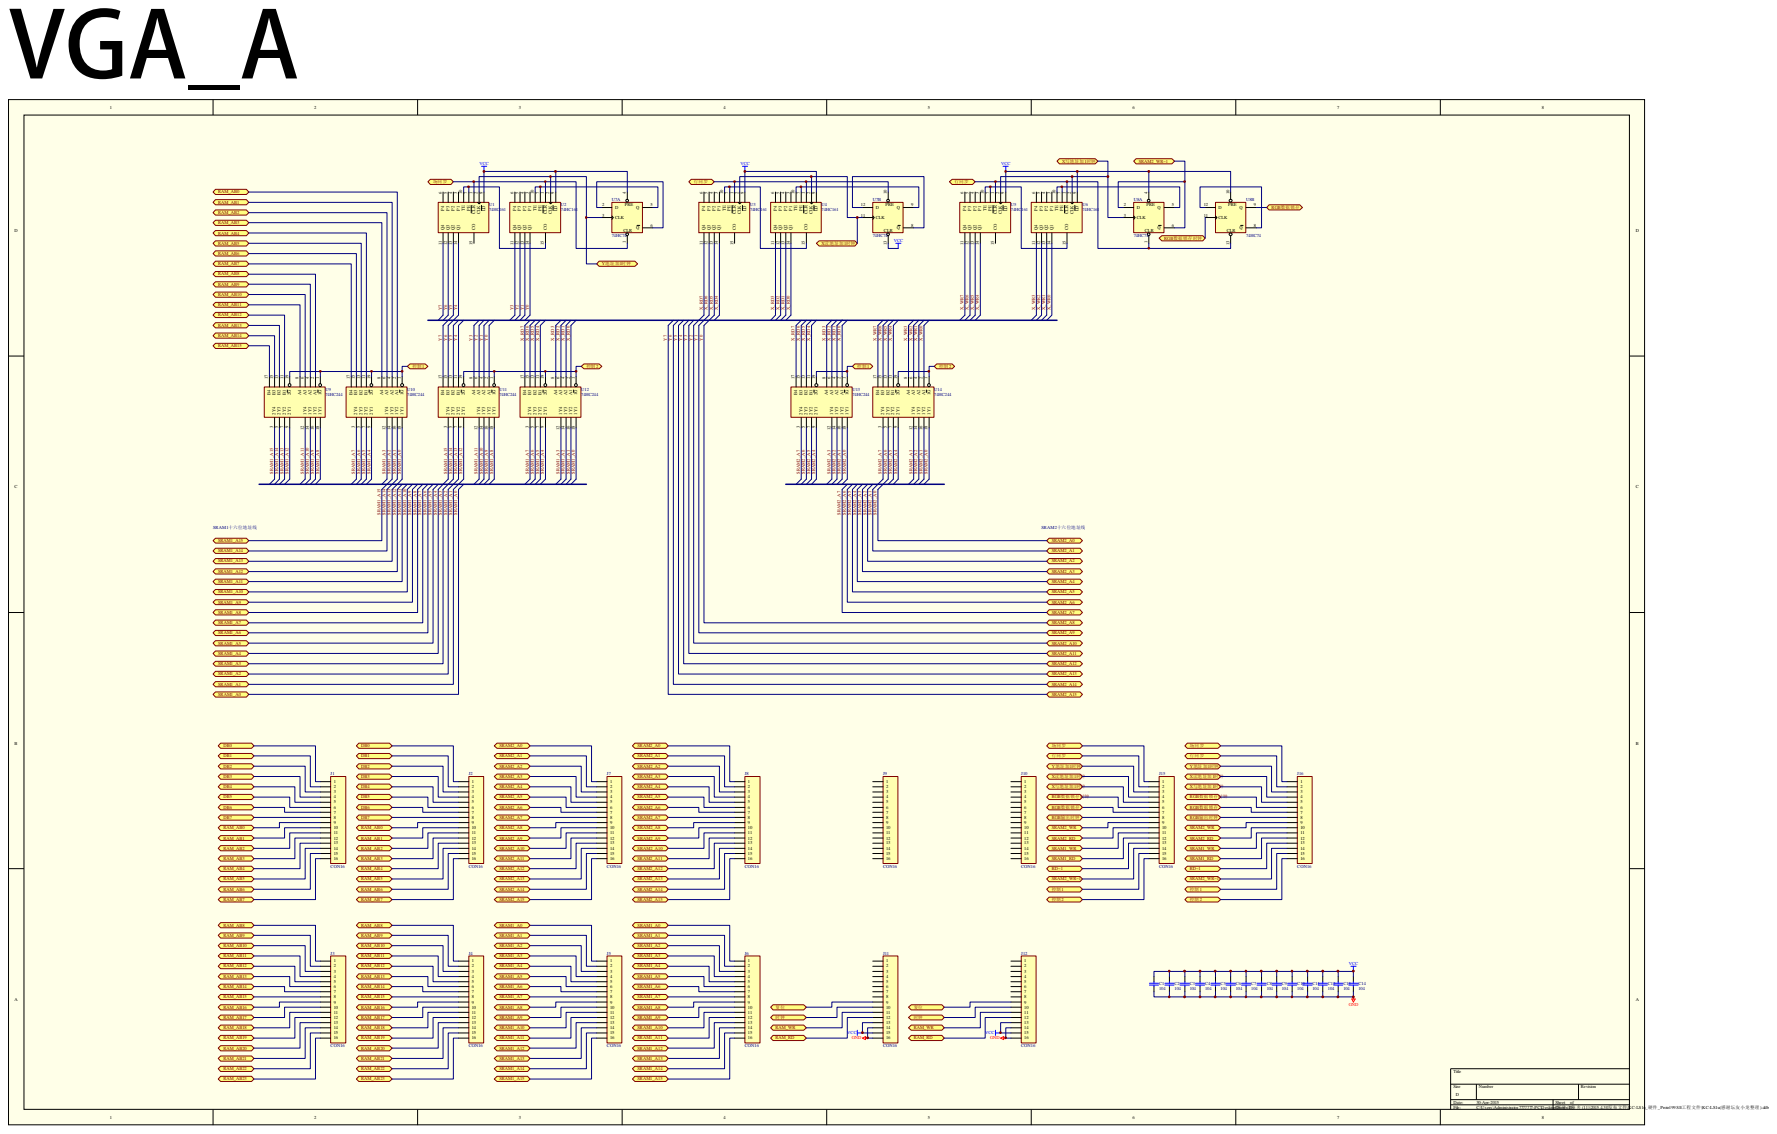
[picture p32: page 12]

# VGA_D

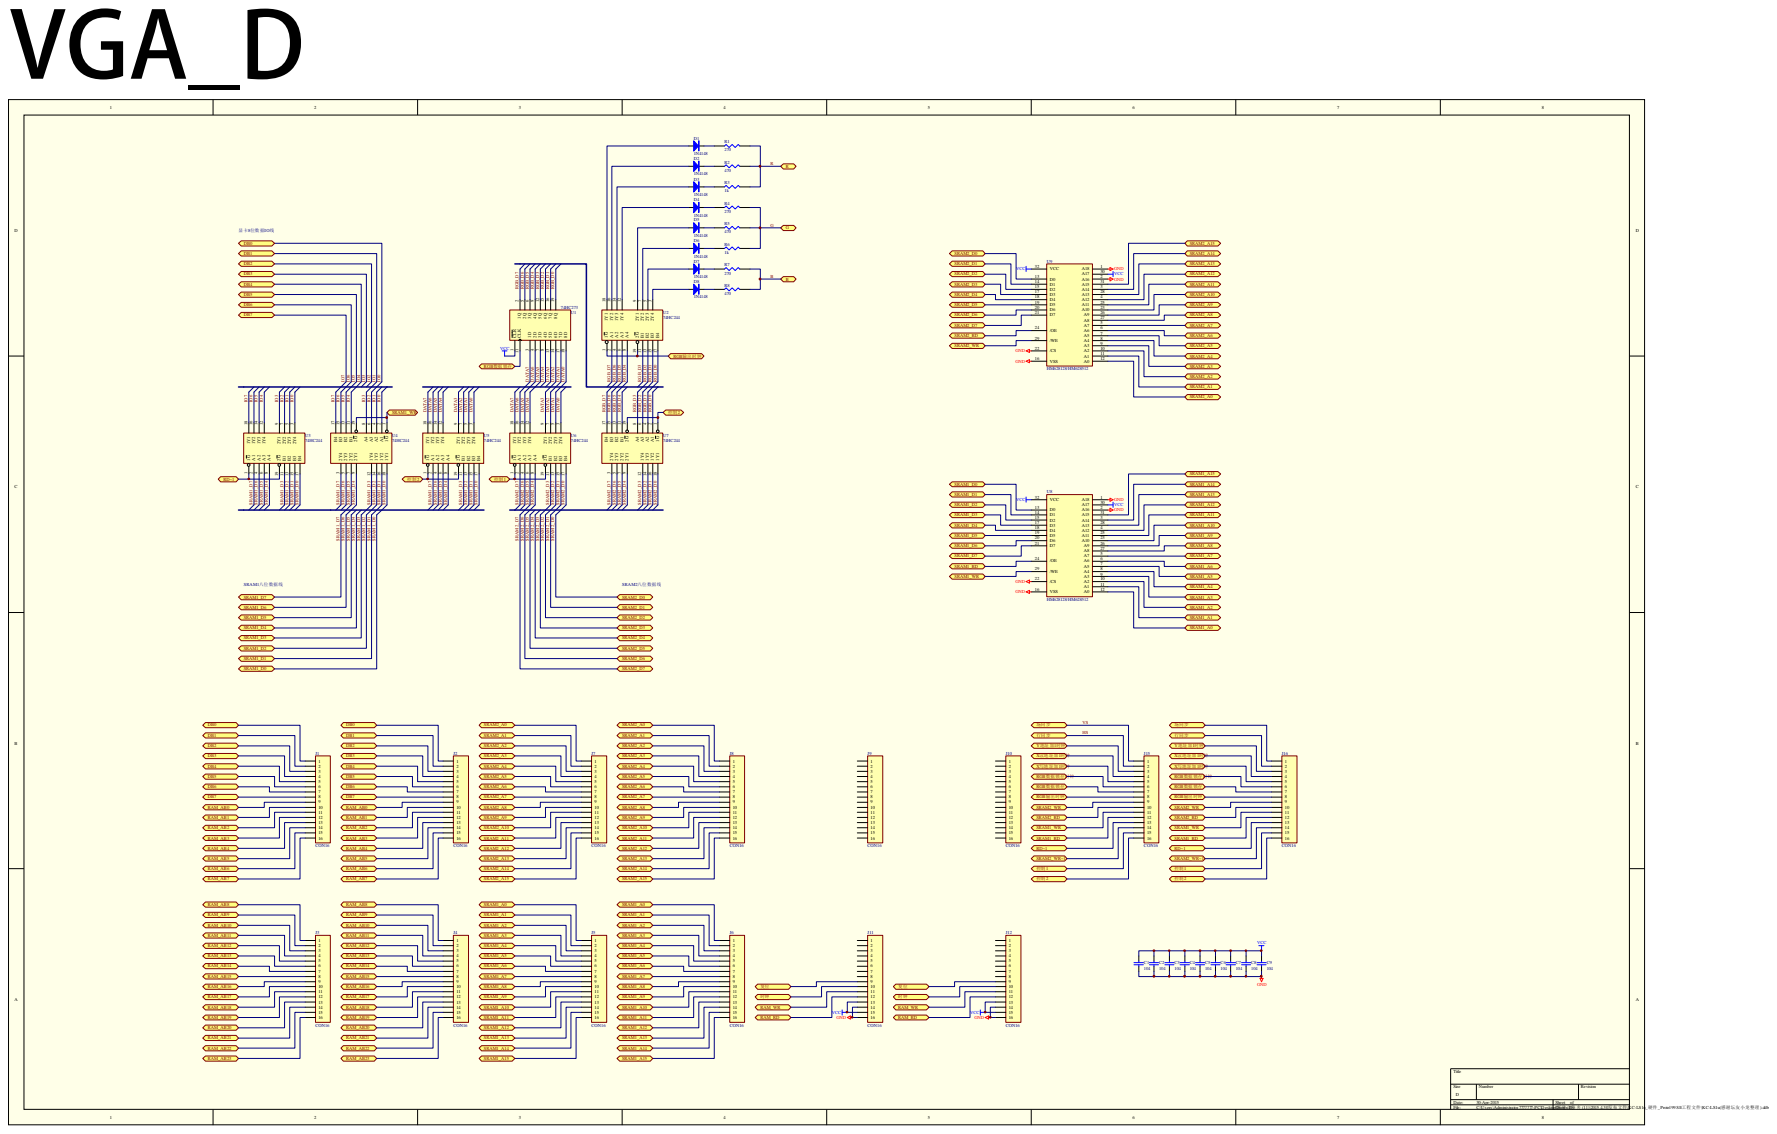
[picture p33: page 13]

# CLK_RST_IO_PS

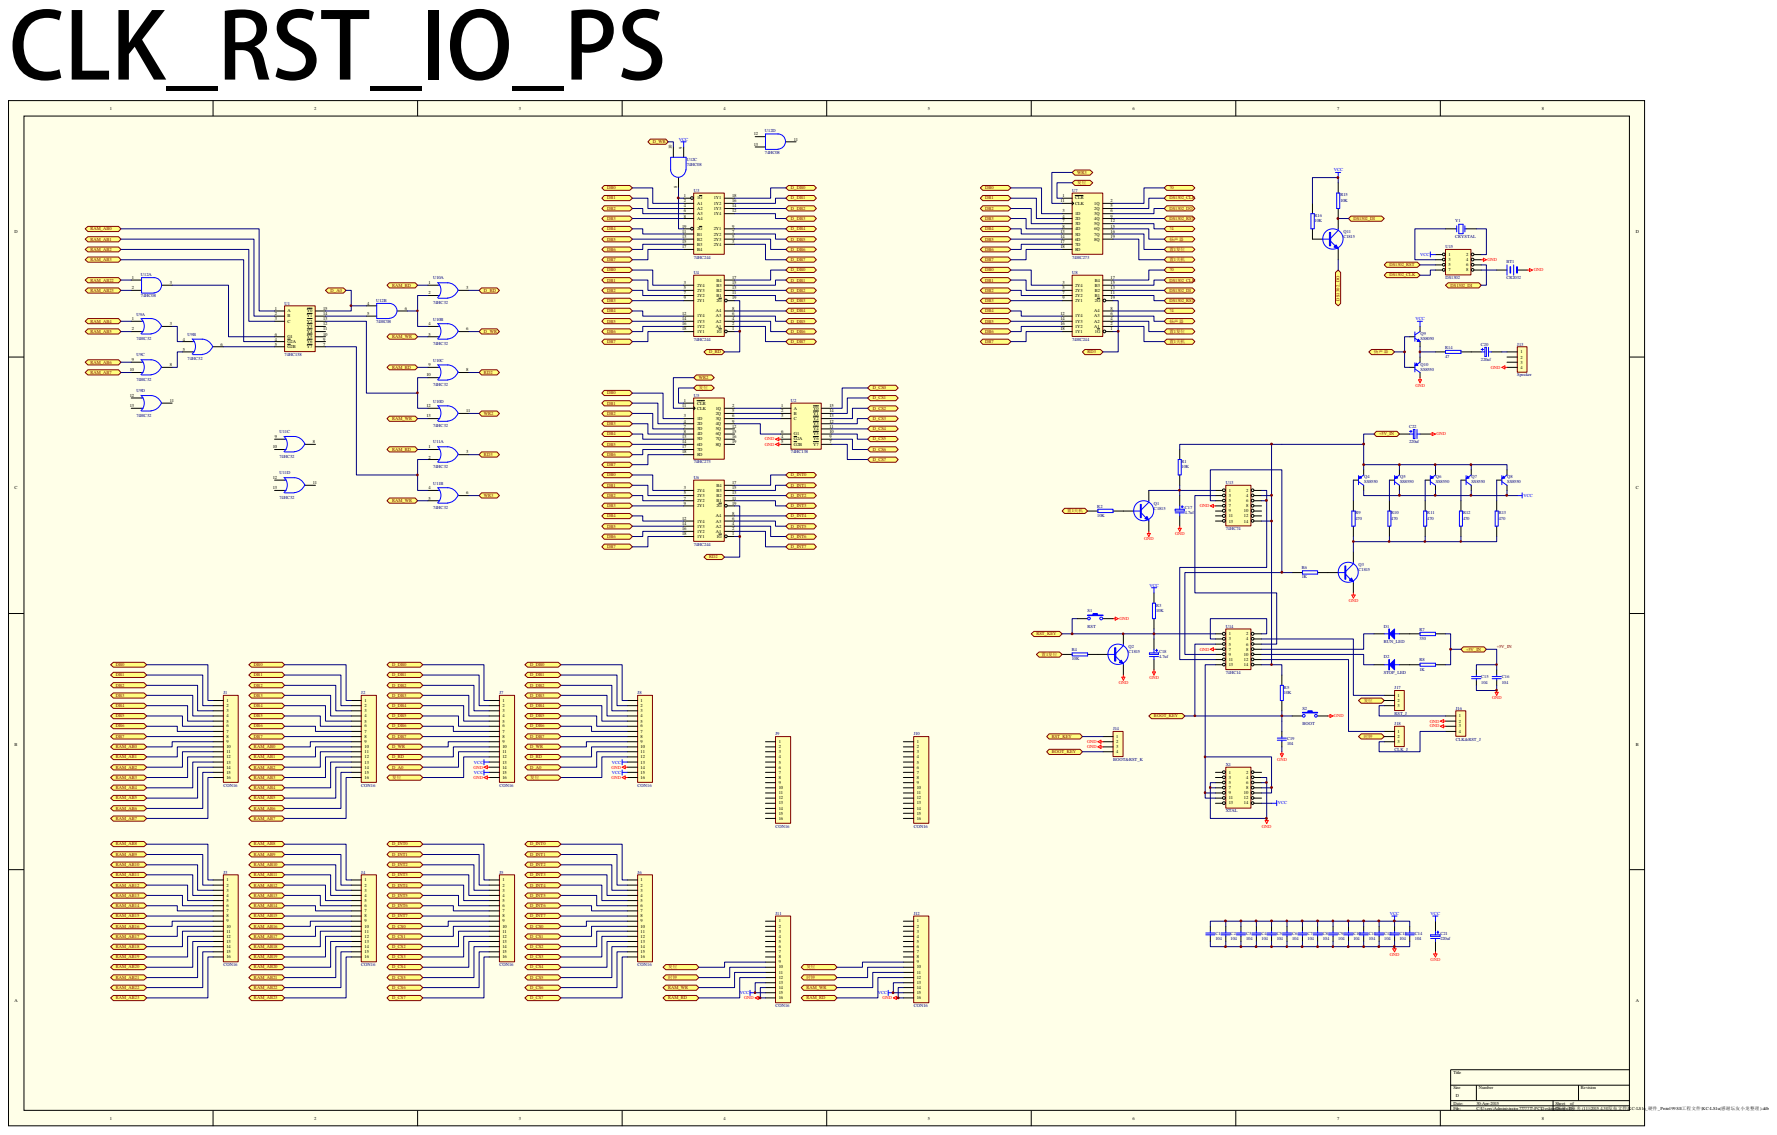
[picture p34: page 14]
