ouyangcong3/LongShaoCPU/(list of files, drawings)

Other design files:
龙少设计CPU/KC-LS1u资料文件(更新1)/KC-LS1u_硬件_Protel 99 SE工程文件/PCB/1.LED v1.1.PCB
龙少设计CPU/KC-LS1u资料文件(更新1)/KC-LS1u_硬件_Protel 99 SE工程文件/PCB/2.ALU v1.1.PCB
龙少设计CPU/KC-LS1u资料文件(更新1)/KC-LS1u_硬件_Protel 99 SE工程文件/PCB/3.A&D v1.1.PCB
龙少设计CPU/KC-LS1u资料文件(更新1)/KC-LS1u_硬件_Protel 99 SE工程文件/PCB/4.EPROM v1.PCB
龙少设计CPU/KC-LS1u资料文件(更新1)/KC-LS1u_硬件_Protel 99 SE工程文件/PCB/5.ROM_CT v1.PCB
龙少设计CPU/KC-LS1u资料文件(更新1)/KC-LS1u_硬件_Protel 99 SE工程文件/PCB/6.SROM v1.PCB
龙少设计CPU/KC-LS1u资料文件(更新1)/KC-LS1u_硬件_Protel 99 SE工程文件/PCB/7.RAM v1.PCB
龙少设计CPU/KC-LS1u资料文件(更新1)/KC-LS1u_硬件_Protel 99 SE工程文件/PCB/8.SPI_C v1.PCB
龙少设计CPU/KC-LS1u资料文件(更新1)/KC-LS1u_硬件_Protel 99 SE工程文件/PCB/9.SPI_D v1.PCB
龙少设计CPU/KC-LS1u资料文件(更新1)/KC-LS1u_硬件_Protel 99 SE工程文件/PCB/10.CT&VGA_CS v1.PCB
龙少设计CPU/KC-LS1u资料文件(更新1)/KC-LS1u_硬件_Protel 99 SE工程文件/PCB/11.VGA_C v1.PCB
龙少设计CPU/KC-LS1u资料文件(更新1)/KC-LS1u_硬件_Protel 99 SE工程文件/PCB/12.VGA_A v1.PCB
龙少设计CPU/KC-LS1u资料文件(更新1)/KC-LS1u_硬件_Protel 99 SE工程文件/PCB/13.VGA_D v1.PCB
龙少设计CPU/KC-LS1u资料文件(更新1)/KC-LS1u_硬件_Protel 99 SE工程文件/PCB/14.CLK_RST_IO_PS v1.PCB
龙少设计CPU/龙少的8位单周期.circ
