ouyangcong3/LongShaoCPU/龙少设计CPU/KC-LS1u资料文件(更新1)/示例程序/扬声器示例程序/main.c

#include<io.h>

void speaker(unsigned int sj,unsigned int pl) //扬声器,sj为持续时间,pl为频率
{

unsigned int x;

   while(--sj != 0)
   {

      XT_C |= 0x20;
      for(x = 0;x != pl;++x);
      XT_C &= 0xdf;
      for(x = 0;x != pl;++x);

   }

}


main()
{

/* 扬声器接 "KC_LS1u_CLK_RST_IO_PS" PCB 的"Speaker"接口*/

     speaker(110,70);
     speaker(110,75);
     speaker(110,80);
     speaker(110,85);
     speaker(110,90);
     speaker(110,95);
     speaker(110,100);
     speaker(110,105);
     speaker(110,110);
     speaker(110,115);
     speaker(110,120);
     speaker(110,125);
     speaker(110,130);


   while(1);
}
