ouyangcong3/LongShaoCPU/龙少设计CPU/KC-LS1u资料文件(更新1)/示例程序/HTTP服务器示例程序/TF.h

void TF_chushihua()
{
  unsigned char j_;

//////////////////复位为SPI模式//////////////////     

  SPI_CS = 0x10;  //SPI速率设置为4分频 并选中空设备
  
  for(j_ = 0;j_ != 8;++j_)SPI_D = 0xff; //发送80个时钟


  SPI_CS = 0x18; //设置速率并选中SD卡

  SPI_D = 0x40;
  while((SPI_INT & 0x80) != 0x80);
  SPI_D = 0x00;
  while((SPI_INT & 0x80) != 0x80);
  SPI_D = 0x00;
  while((SPI_INT & 0x80) != 0x80);
  SPI_D = 0x00;
  while((SPI_INT & 0x80) != 0x80);
  SPI_D = 0x00;
  while((SPI_INT & 0x80) != 0x80);
  SPI_D = 0x95;
  while((SPI_INT & 0x80) != 0x80);

  SPI_S = 0x02; //SPI输出1

  while(SPI_D != 0x01) while((SPI_INT & 0x80) != 0x80); //读到0x01跳出


///////////////////初始化/////////////////////////

 while(SPI_D != 0x00)
 {

    SPI_S = 0x01; //SPI关闭输出1

    SPI_CS = 0x00; //选中空设备

    SPI_D = 0xff;   //填充8个时钟
    while((SPI_INT & 0x80) != 0x80);

    SPI_CS = 0x18; //设置速率并选中SD卡

    SPI_D = 0x41;
    while((SPI_INT & 0x80) != 0x80);
    SPI_D = 0x00;
    while((SPI_INT & 0x80) != 0x80);
    SPI_D = 0x00;
    while((SPI_INT & 0x80) != 0x80);
    SPI_D = 0x00;
    while((SPI_INT & 0x80) != 0x80);
    SPI_D = 0x00;
    while((SPI_INT & 0x80) != 0x80);
    SPI_D = 0xff;
    while((SPI_INT & 0x80) != 0x80);

    SPI_S = 0x02; //SPI输出1

    SPI_D = 0xff;
    while((SPI_INT & 0x80) != 0x80);
    SPI_D = 0xff;
    while((SPI_INT & 0x80) != 0x80);

 }

  SPI_S = 0x01; //SPI关闭输出1

  SPI_CS = 0x00; //选中空设备
  SPI_D = 0xff;
  while((SPI_INT & 0x80) != 0x80);

}

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
  SPI_D = DATA[501];
  SPI_D = DATA[502];
  SPI_D = DATA[503];

  SPI_D = DATA[504];
  SPI_D = DATA[505];
  SPI_D = DATA[506];
  SPI_D = DATA[507];
  SPI_D = DATA[508];
  SPI_D = DATA[509];
  SPI_D = DATA[510];
  SPI_D = DATA[511];

  while((SPI_INT & 0x80) != 0x80);
  SPI_CS = 0x00;

}
