ouyangcong3/LongShaoCPU/龙少设计CPU/KC-LS1u资料文件(更新1)/示例程序/USB鼠标示例程序/VGA.h

/*----使用此函数要把下面的变量定义拷贝到"qjbldy.h"-----

unsigned char VGA_CT2_; //记录硬件计数器高16位的低8位数据,用于和最新的计数器数据比较

unsigned char GB2312[196608]; //GB2312字库,字符大小12*12,占384个扇区

unsigned char ASCII[] =  //ASCII字库,字符大小12*6
 
{

0x00,0x00,0x00,0x00,0x00,0x00,0x00,0x00,0x00,0x00,0x00,0x00,///*" ",0

0x00,0x00,0x00,0x00,0x00,0x00,0x00,0x00,0x00,0x00,0x00,0x00,///*"",1

0x00,0x00,0x00,0x00,0x00,0x00,0xF0,0x10,0x10,0x10,0x10,0x10,///*"",2

0x10,0x10,0x10,0x10,0x10,0x10,0x1C,0x00,0x00,0x00,0x00,0x00,///*"",3

0x10,0x10,0x10,0x10,0x10,0x10,0xF0,0x00,0x00,0x00,0x00,0x00,///*"",4

0x10,0x10,0x10,0x10,0x10,0x10,0x10,0x10,0x10,0x10,0x10,0x10,///*"",5

0x00,0x00,0x00,0x00,0x00,0x00,0xFC,0x00,0x00,0x00,0x00,0x00,///*"",6

0x00,0x00,0x00,0x30,0x78,0x78,0x78,0x30,0x00,0x00,0x00,0x00,///*"",7

0xFC,0xFC,0xFC,0xCC,0x84,0x84,0x84,0xCC,0xFC,0xFC,0xFC,0xFC,///*"",8

0x00,0x00,0x00,0x00,0x00,0x00,0x00,0x00,0x00,0x00,0x00,0x00,///*"	",9

0x00,0x00,0x00,0x00,0x00,0x00,0x00,0x00,0x00,0x00,0x00,0x00,///*" ",10

0x00,0x1C,0x0C,0x0C,0x14,0x10,0x30,0x48,0x48,0x30,0x00,0x00,///*"
",11

0x00,0x38,0x44,0x44,0x38,0x10,0x7C,0x10,0x10,0x10,0x00,0x00,///*"
",12

0x00,0x00,0x00,0x00,0x00,0x00,0x00,0x00,0x00,0x00,0x00,0x00,///*" ",13

0x00,0x0C,0x34,0x2C,0x34,0x24,0x24,0x2C,0x6C,0x60,0x00,0x00,///*"",14

0x00,0x54,0x54,0x28,0x28,0x6C,0x28,0x28,0x54,0x54,0x00,0x00,///*"",15

0x10,0x10,0x10,0x10,0x10,0x10,0xFC,0x10,0x10,0x10,0x10,0x10,///*"",16

0x00,0x04,0x0C,0x1C,0x3C,0x7C,0x3C,0x1C,0x0C,0x04,0x00,0x00,///*"",17

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

0x00,0x00,0x00,0x00,0x00,0xD8,0x48,0x48,0x48,0x3C,0x00,0x00,///*"u",117

0x00,0x00,0x00,0x00,0x00,0xEC,0x48,0x50,0x30,0x20,0x00,0x00,///*"v",118

0x00,0x00,0x00,0x00,0x00,0xA8,0xA8,0x70,0x50,0x50,0x00,0x00,///*"w",119

0x00,0x00,0x00,0x00,0x00,0xD8,0x50,0x20,0x50,0xD8,0x00,0x00,///*"x",120

0x00,0x00,0x00,0x00,0x00,0xEC,0x48,0x50,0x30,0x20,0x20,0xC0,///*"y",121

0x00,0x00,0x00,0x00,0x00,0x78,0x10,0x20,0x20,0x78,0x00,0x00,///*"z",122

0x00,0x18,0x10,0x10,0x10,0x20,0x10,0x10,0x10,0x10,0x18,0x00,///*"{",123

0x10,0x10,0x10,0x10,0x10,0x10,0x10,0x10,0x10,0x10,0x10,0x10,///*"|",124

0x00,0x60,0x20,0x20,0x20,0x10,0x20,0x20,0x20,0x20,0x60,0x00,///*"}",125

0x40,0xA4,0x18,0x00,0x00,0x00,0x00,0x00,0x00,0x00,0x00,0x00,///*"~",126

0x00,0x00,0x00,0x00,0x00,0x00,0x00,0x00,0x00,0x00,0x00,0x00 ///*"",127

};

*/




void VGA_VRAM_LD() //读写VRAM显存之前要调用此函数
{

/***************************** 允许VRAM更新时间 = VGA_CL1 * (65536 / CPU主频) = 21.845毫秒 *****************************/

#define VGA_CL1 4

/***********************************************************************************************************************/

   while((VGA_CT2_ < 256 - VGA_CL1 && (CT2 < VGA_CT2_ || CT2 >= VGA_CT2_ + VGA_CL1)   ||   VGA_CT2_ > 255 - VGA_CL1 && CT2 < VGA_CT2_ && CT2 >= VGA_CT2_ + VGA_CL1) == 0); //上次记录的硬件计数器数据和现在硬件计数器的数据进行比较,达到条件时跳出
   CTVGA_C &= 0xfe; //请求访问VRAM
   while((CTVGA_C & 0x80) == 0x80); //VRAM可以访问的时候跳出


}


void VGA_VRAM_UP() //写入显存的数据更新到屏幕,VRAM读写完成后要调用此函数
{
   CTVGA_C |= 0x01; //请求VRAM显示
   VGA_CT2_ = CT2;  //记录当前硬件计数器数据
}



void VGA_SK0(unsigned char Y,unsigned char _Y,unsigned char DATA) //画色块0,Y为起始坐标,_Y为结束坐标,X坐标256全部写像素,12MHZ的CPU频率下每秒可以执行约40次
{

 while(Y != _Y)
 {

   _B = DATA;
   _A = 0;

   do
   {
     _A1 = Y;
     _A2 = 0x80;

     _A0 = _A;
     _NOP;
     _RAM = _B;
     _A = _A + 1;

     _A0 = _A;
     _NOP;
     _RAM = _B;
     _A = _A + 1;

     _A0 = _A;
     _NOP;
     _RAM = _B;
     _A = _A + 1;

     _A0 = _A;
     _NOP;
     _RAM = _B;
     _A = _A + 1;

     _A0 = _A;
     _NOP;
     _RAM = _B;
     _A = _A + 1;

     _A0 = _A;
     _NOP;
     _RAM = _B;
     _A = _A + 1;

     _A0 = _A;
     _NOP;
     _RAM = _B;
     _A = _A + 1;

     _A0 = _A;
     _NOP;
     _RAM = _B;
     _A = _A + 1;

   }while(_SUB_A_1 != -1);

   ++Y;

 }


}



void VGA_SK1(unsigned char y,unsigned char x,unsigned char _y,unsigned char _x,unsigned char data) //画色块1,yx为起始坐标,_y_x为点数,data像素数据
{

unsigned char x_;


  if(_y != 0 && _x != 0)
  {

    x_ = x;
    _y += y;
    _x += x;

    do
    {
       do
       {
          _B = data;
          _A = y;
          _A0 = x;
          _A2 = 0x80;
          _A1 = _A;
          _NOP;
          _RAM = _B;
          ++x;

       }while(x != _x);

       x = x_;
       ++y;

    }while(y != _y);

  }

}


void VGA_ZX(unsigned char y,unsigned char x,unsigned char _y,unsigned char _x,unsigned char data) //画直线,yx为起始坐标,_y_x为结束坐标,data像素数据
{

unsigned int _y_; //Y坐标差值
unsigned int _x_;  //X坐标差值
unsigned char _y1; //_y坐标+-1
unsigned char _x1; //_x坐标+1

unsigned char js0;
unsigned int js1;
unsigned int js2;
unsigned char js3;
unsigned char js4;


    if(_x < x) //X坐标反方向
    {
        js0 = x;
        x = _x;
        _x = js0;

        js0 = y;
        y = _y;
        _y = js0;
    }


    if(_y < y) //Y坐标反方向
    {
       _y1 = _y - 1;
       _y_ = y - _y;
       ++_y_;
       js0 = -1;
    }
    else //Y坐标正方向
    {
       _y1 = _y + 1;
       _y_ = _y - y;
       ++_y_;
       js0 = 1;
    }

    _x1 = _x + 1;
    _x_ = _x - x;
    ++_x_;


    if(_y_ == _x_) //正方形对角
    {

        do
        {
            _B = data;
            _A = y;
            _A0 = x;
            _A2 = 0x80;
            _A1 = _A;
            _NOP;
            _RAM = _B;
            y += js0;
            ++x;

        }while(y != _y1);

    }
    else if(_y_ > _x_) //竖的长方形对角
    {

        js1 = _x_;
        js1 <<= 8;
        js1 = js1 / _y_; //计算出比例增值
        js2 = x;
        js2 <<= 8;

        do
        {

            js2 += js1;
            x = js2 >> 8;
            if(x == _x1) x = _x; //限制

            _B = data;
            _A = y;
            _A0 = x;
            _A2 = 0x80;
            _A1 = _A;
            _NOP;
            _RAM = _B;
            y += js0;


        }while(y != _y1);

    }
    else //横的长方形对角
    {

        js1 = _y_;
        js1 <<= 8;
        js1 = js1 / _x_; //计算出比例增值
        js2 = 0;
        js3 = y;


        do
        {

            js2 += js1;
            js4 = js2 >> 8;

            if(js3 > _y)
            {
                y = js3 - js4;
            }
            else
            {
                y = js3 + js4;
            }

            if(y == _y1) y = _y; //限制


            _B = data;
            _A = y;
            _A0 = x;
            _A2 = 0x80;
            _A1 = _A;
            _NOP;
            _RAM = _B;
            ++x;

        }while(x != _x1);



    }


}


void VGA_kuang0(unsigned char y,unsigned char x,unsigned char _y,unsigned char _x,unsigned char data) //画框0,yx为起始坐标,_y_x为点数+1,data像素数据
{

unsigned char x_;
unsigned char y_;


  if(_y != 0 && _x != 0)
  {

    x_ = x;
    y_ = y;
    _y += y;
    _x += x;


       do
       {
          _B = data;
          _A = y;
          _A0 = x;
          _A2 = 0x80;
          _A1 = _A;
          _NOP;
          _RAM = _B;
          ++x;

       }while(x != _x);

       do
       {
          _B = data;
          _A = y;
          _A0 = x;
          _A2 = 0x80;
          _A1 = _A;
          _NOP;
          _RAM = _B;
          ++y;

       }while(y != _y);

       do
       {
          _B = data;
          _A = y;
          _A0 = x;
          _A2 = 0x80;
          _A1 = _A;
          _NOP;
          _RAM = _B;
          --x;

       }while(x != x_);

       do
       {
          _B = data;
          _A = y;
          _A0 = x;
          _A2 = 0x80;
          _A1 = _A;
          _NOP;
          _RAM = _B;
          --y;

       }while(y != y_);


  }

}


void VGA_ASCII(unsigned char y,unsigned char x,unsigned int ascii_data,unsigned char rgb_data) //显示默认大小ASCII码,yx为起始坐标,ascii_data为ASCII值,rgb_data像素数据
{

unsigned char x_;
unsigned char b_x;
unsigned char bit_data;
unsigned char *_addr;


     x_ = x;
     _addr = ASCII + ascii_data * 12;

     b_x = 0;

     do
     {

          bit_data = *_addr;


          if((bit_data & 0x80) != 0) _B = rgb_data,_A = y,_A0 = x,_A2 = 0x80,_A1 = _A,_NOP,_RAM = _B; ++x;
          if((bit_data & 0x40) != 0) _B = rgb_data,_A = y,_A0 = x,_A2 = 0x80,_A1 = _A,_NOP,_RAM = _B; ++x;
          if((bit_data & 0x20) != 0) _B = rgb_data,_A = y,_A0 = x,_A2 = 0x80,_A1 = _A,_NOP,_RAM = _B; ++x;
          if((bit_data & 0x10) != 0) _B = rgb_data,_A = y,_A0 = x,_A2 = 0x80,_A1 = _A,_NOP,_RAM = _B; ++x;
          if((bit_data & 0x08) != 0) _B = rgb_data,_A = y,_A0 = x,_A2 = 0x80,_A1 = _A,_NOP,_RAM = _B; ++x;
          if((bit_data & 0x04) != 0) _B = rgb_data,_A = y,_A0 = x,_A2 = 0x80,_A1 = _A,_NOP,_RAM = _B;


          ++_addr;
          ++b_x;
          x = x_;
          ++y;

     }while(b_x != 12);


}

void VGA_GB2312(unsigned char y,unsigned char x,unsigned char *GB2312_data,unsigned char rgb_data) //显示默认大小GB2312码,yx为起始坐标,GB2312_data为GB2312字符串,rgb_data像素数据
{

unsigned char x_;
unsigned char b_x;
unsigned char D1;
unsigned char D2;
unsigned long int ZADDR;
unsigned char *_addr;

unsigned int DH;
unsigned int DL;

  DH = GB2312_data[0];
  DL = GB2312_data[1];

  x_ = x;
  ZADDR = (DH - 0xa1) * 94 + (DL - 0xa1); //算出GB2312字符地址
  ZADDR *= 24; //一个字符占字库24个字节 乘24算出GB2312字库地址

  _addr = GB2312 + ZADDR;


  b_x = 0;

  do
  {

     D1 = *_addr;  //读出高8位像素字节
     ++_addr;
     D2 = *_addr;  //读出低8位像素字节
     ++_addr;

     if((D1 & 0x80) != 0) _B = rgb_data,_A = y,_A0 = x,_A2 = 0x80,_A1 = _A,_NOP,_RAM = _B; ++x;
     if((D1 & 0x40) != 0) _B = rgb_data,_A = y,_A0 = x,_A2 = 0x80,_A1 = _A,_NOP,_RAM = _B; ++x;
     if((D1 & 0x20) != 0) _B = rgb_data,_A = y,_A0 = x,_A2 = 0x80,_A1 = _A,_NOP,_RAM = _B; ++x;
     if((D1 & 0x10) != 0) _B = rgb_data,_A = y,_A0 = x,_A2 = 0x80,_A1 = _A,_NOP,_RAM = _B; ++x;
     if((D1 & 0x08) != 0) _B = rgb_data,_A = y,_A0 = x,_A2 = 0x80,_A1 = _A,_NOP,_RAM = _B; ++x;
     if((D1 & 0x04) != 0) _B = rgb_data,_A = y,_A0 = x,_A2 = 0x80,_A1 = _A,_NOP,_RAM = _B; ++x;
     if((D1 & 0x02) != 0) _B = rgb_data,_A = y,_A0 = x,_A2 = 0x80,_A1 = _A,_NOP,_RAM = _B; ++x;
     if((D1 & 0x01) != 0) _B = rgb_data,_A = y,_A0 = x,_A2 = 0x80,_A1 = _A,_NOP,_RAM = _B; ++x;

     if((D2 & 0x80) != 0) _B = rgb_data,_A = y,_A0 = x,_A2 = 0x80,_A1 = _A,_NOP,_RAM = _B; ++x;
     if((D2 & 0x40) != 0) _B = rgb_data,_A = y,_A0 = x,_A2 = 0x80,_A1 = _A,_NOP,_RAM = _B; ++x;
     if((D2 & 0x20) != 0) _B = rgb_data,_A = y,_A0 = x,_A2 = 0x80,_A1 = _A,_NOP,_RAM = _B; ++x;
     if((D2 & 0x10) != 0) _B = rgb_data,_A = y,_A0 = x,_A2 = 0x80,_A1 = _A,_NOP,_RAM = _B;


     x = x_; //x坐标恢复起点
     ++y; //y地址加1
     ++b_x;

  }while(b_x != 12);


}




void VGA_U32_Dprint(unsigned char y,unsigned char x,unsigned long int XX,unsigned char rgb_data) //32位无符号数转十进制显示,yx为起始坐标,XX为32位数,rgb_data像素数据
{

unsigned char i;
unsigned char k = 0;


  i = XX / 1000000000;
  if(i != 0) VGA_ASCII(y,x,'0'+i,rgb_data),x+=6,k = 1;  //"十亿位"

  XX %= 1000000000;
  i = XX / 100000000;
  if(k != 0 || i != 0) VGA_ASCII(y,x,'0'+i,rgb_data),x+=6,k = 1;  //"亿位"

  XX %= 100000000;
  i = XX / 10000000;
  if(k != 0 || i != 0) VGA_ASCII(y,x,'0'+i,rgb_data),x+=6,k = 1;  //"千万位"

  XX %= 10000000;
  i = XX / 1000000;
  if(k != 0 || i != 0) VGA_ASCII(y,x,'0'+i,rgb_data),x+=6,k = 1;  //"百万位"

  XX %= 1000000;
  i = XX / 100000;
  if(k != 0 || i != 0) VGA_ASCII(y,x,'0'+i,rgb_data),x+=6,k = 1;  //"十万位"

  XX %= 100000;
  i = XX / 10000;
  if(k != 0 || i != 0) VGA_ASCII(y,x,'0'+i,rgb_data),x+=6,k = 1;  //"万位"

  XX %= 10000;
  i = XX / 1000;
  if(k != 0 || i != 0) VGA_ASCII(y,x,'0'+i,rgb_data),x+=6,k = 1;  //"千位"

  XX %= 1000;
  i = XX / 100;
  if(k != 0 || i != 0) VGA_ASCII(y,x,'0'+i,rgb_data),x+=6,k = 1;  //"百位"

  XX %= 100;
  i = XX / 10;
  if(k != 0 || i != 0) VGA_ASCII(y,x,'0'+i,rgb_data),x+=6;  //"十位"


  VGA_ASCII(y,x,'0' + XX % 10,rgb_data);  //"个位"


}



void VGA_CS_RGB256() //测试显示256种颜色
{

unsigned char x;
unsigned char y;
unsigned char data;

   data = 0;
   y = 12;

   do
   {
      x = 12;
      do
      {
         VGA_SK1(y,x,12,12,data);
         x += 14;
         ++data;

      }while(x != 236);

      y += 14;

   }while(y != 236);


}
