ouyangcong3/LongShaoCPU/龙少设计CPU/KC-LS1u资料文件(更新1)/示例程序/显示中文字符串示例程序/add_sys.h

/*----使用此函数要把下面的变量定义拷贝到"qjbldy.h"-----

unsigned char KC_LS1u_boot_0_txt_LJ[1024]; //引导0文本路径
unsigned int KC_LS1u_boot_0_txt_X; //路径长度
unsigned char KC_LS1u_boot_0_txt_device; //引导0文本路径指向的设备

*/


unsigned char ADD_SYS_KC_LS1u_boot_txt() //加载引导文本路径,返回值为1表示成功
{

unsigned char buf[512];
unsigned char device = 0;
unsigned long int WJDX;


unsigned char js0;
unsigned int js1;
unsigned int js2;
unsigned int js3;
unsigned int js4;

unsigned char returnX;

    do
    {
       if(FAT32_OPENWJ(device,0x00000002,0,"KC_LS1u_boot_0.txt") != 0) break;
       ++device;

    }while(device != 2);

    if(device != 2) //打开引导文本成功
    {

       if((WJDX = FAT32_RETURN_WJDX_(device,0)) < 513 && WJDX > 12)
       {

           if(FAT32_RDWJ_512B(device,0,buf) == 1) //读出512B
           {

                if(buf[0] == 's' && buf[1] == 'p' && buf[2] == 'i' && buf[3] == '_' && buf[4] == 'd' && buf[5] == 'e' && buf[6] == 'v' && buf[7] == 'i' && buf[8] == 'c' && buf[9] == 'e' && buf[11] == ':' && (buf[10] == '_' || buf[10] == '0' || buf[10] == '1'))
                {

                    if(buf[10] == '_') KC_LS1u_boot_0_txt_device = device; else KC_LS1u_boot_0_txt_device = buf[10];


                    js1 = 0;
                    js2 = 12;
                    js4 = WJDX;

                    do
                    {

                        KC_LS1u_boot_0_txt_LJ[js1] = buf[js2];
                        ++js1;
                        ++js2;

                    }while(js2 < js4);

                    --js1;
                    while(js1 != 0 && KC_LS1u_boot_0_txt_LJ[js1] != '\') --js1;

                    if(js1 == 0)
                    {
                        KC_LS1u_boot_0_txt_X = 0;
                    }
                    else
                    {
                        KC_LS1u_boot_0_txt_X = js1 + 1;
                    }

                    returnX = 1;

                }
                else  //设备描述不对进入处理
                {
                   returnX = 4;
                }

           }
           else //读文件失败
           {
              returnX = 3;
           }

       }
       else //引导文本超出512字节,或小于13字节
       {
          returnX = 2;
       }

    }
    else //没有找到引导文本
    {
       returnX = 0;
    }

    return returnX;

}



unsigned char *BOOT_LJ_ADD_LJ(unsigned char *ADD_LJ) //引导文本路径增加
{

unsigned char *_addr;
unsigned int ADD_LJ_CD;

unsigned int js1;

   _addr = & KC_LS1u_boot_0_txt_LJ[KC_LS1u_boot_0_txt_X];

   ADD_LJ_CD = 0;
   while(ADD_LJ_CD != 512 && ADD_LJ[ADD_LJ_CD] != 0) ++ADD_LJ_CD; //取增加路径的长度

   js1 = 0;
   while(js1 != ADD_LJ_CD) *_addr = ADD_LJ[js1],++_addr,++js1;

   *_addr = 0;

   return KC_LS1u_boot_0_txt_LJ;

}



unsigned char ADD_SYS_GB2312_bin() //加载系统文件GB2312.bin(初始化GB2312数组)
{

unsigned char returnX;
unsigned char *_GB2312;

unsigned char js1;


   if(FAT32_OPENWJ(KC_LS1u_boot_0_txt_device,0x00000002,0,BOOT_LJ_ADD_LJ("字库文件\中文字库.bin")) != 0) //找到文件GB2312.bin
   {
       _GB2312 = GB2312;
       while((js1 = FAT32_RDWJ_512B(KC_LS1u_boot_0_txt_device,0,_GB2312)) == 1) _GB2312 += 512; //加载GB2312.bin数据

       if(js1 == 2) returnX = 1; //加载完成
       else returnX = 6; //中途出错
   }
   else //没有找到文件GB2312.bin
   {
      returnX = 5;
   }

   return returnX;

}

unsigned char ADD_SYS() //加载系统文件
{

unsigned char returnX;

    if((returnX = ADD_SYS_KC_LS1u_boot_txt()) == 1)  //加载引导路径
    if((returnX = ADD_SYS_GB2312_bin()) == 1);       //加载GB2312.bin

    return returnX;

}
