ouyangcong3/LongShaoCPU/龙少设计CPU/KC-LS1u资料文件(更新1)/示例程序/HTTP服务器示例程序/ds1302.h

void DS1302_WR(unsigned char addr,unsigned char data)
{

  unsigned char i;

  XT_C |= 0x08; //DS1302_CS = 1 启动DS1302

  XT_C &=~0x04; //DS1302_DATA = 0 发送读写控制位 1读0写

  XT_C |= 0x02; //DS1302_CLK = 1
  XT_C &=~0x02; //DS1302_CLK = 0

  for(i = 0;i != 6;++i) //发送6位地址
  {

    XT_C = (XT_C &~0x04) | ((addr & 0x01) << 2);

    XT_C |= 0x02; //DS1302_CLK = 1
    XT_C &=~0x02; //DS1302_CLK = 0

    addr >>= 1;

  }

  XT_C |= 0x04; //DS1302_DATA = 1 发送停止位1

  XT_C |= 0x02; //DS1302_CLK = 1
  XT_C &=~0x02; //DS1302_CLK = 0


  for(i = 0;i != 8;++i) //发送8位数据
  {

    XT_C = (XT_C &~0x04) | ((data & 0x01) << 2);

    XT_C |= 0x02; //DS1302_CLK = 1
    XT_C &=~0x02; //DS1302_CLK = 0

    data >>= 1;

  }

  XT_C &=~0x08; //DS1302_CS = 0 关闭DS1302

}

unsigned char DS1302_RD(unsigned char addr)
{

  unsigned char i,data = 0;

  XT_C |= 0x08; //DS1302_CS = 1 启动DS1302

  XT_C |= 0x04; //DS1302_DATA = 1 发送读写控制位 1读0写

  XT_C |= 0x02; //DS1302_CLK = 1
  XT_C &=~0x02; //DS1302_CLK = 0

  for(i = 0;i != 6;++i) //发送6位地址
  {

    XT_C = (XT_C &~0x04) | ((addr & 0x01) << 2);

    XT_C |= 0x02; //DS1302_CLK = 1
    XT_C &=~0x02; //DS1302_CLK = 0

    addr >>= 1;

  }

  XT_C |= 0x04; //DS1302_DATA = 1 发送停止位1

  for(i = 0;i != 8;++i) //接收8位数据
  {

    data >>= 1;
    XT_C |= 0x02; //DS1302_CLK = 1
    XT_C = (XT_C &~0x02) | 0x04; //DS1302_CLK = 0

    if((XT_C & 0x04) == 0x04) data += 0x80;

  }

  XT_C &=~0x08; //DS1302_CS = 0 关闭DS1302

  return data;

}
